jasonBrom/ch592f-keydeck/web/README.md

# KeyDeck 控制台

无框架的静态 HTML / CSS / ES Modules，设备协议、编辑器与模型资源均位于 `public/`，不依赖 CDN。Node 22+ 用于测试和静态打包；运行设备控制台本身不需要 Node。

```sh
python start-console.py            # 本地设备控制台，默认 localhost:8792
npm test                          # 浏览器逻辑与配置协议测试
npm run build                     # 输出 dist/，并检查资源与相对路径
```

Windows 可以双击 `StartConsole.cmd`；需要配对蓝牙管理时安装 `requirements-windows.txt`，启动器可安装到本目录 `.runtime/`。不要通过 `file://` 直接打开 HTML。

| 运行方式 | USB | 浏览器蓝牙 | Windows 已配对蓝牙 |
| --- | --- | --- | --- |
| GitHub Pages / HTTPS | WebHID | Web Bluetooth | 启动本地服务后点击「Windows 已配对」 |
| Python 本地控制台 | WebHID | Web Bluetooth | Bleak / WinRT，可用时自动识别 |
| 普通静态 localhost | WebHID | Web Bluetooth | 不可用 |

以上接口还取决于浏览器、系统与权限。首次选设备需点击授权；在线页与本地页的权限分别管理。在线页仅在点击「连接设备」或「Windows 已配对」后访问 `127.0.0.1:8792`；首次可能需要允许浏览器访问本机网络。电脑必须运行本地服务，GitHub Pages 无法直接运行 WinRT。没有云端设备数据存储。

## 主要代码

- `public/index.html`：页面结构和控件。
- `public/config/console.css`、`console-shell.css`：与原本地版一致的深色界面；`connection-ui.css` 补充连接指引，`workspace.css` 定义模型/编辑器比例与紧凑布局。
- `public/config/console.js`：草稿、改键、宏和统一测试/保存流程。
- `public/config/console-experience.js`：运行环境、无震动版提示与键盘导航。
- `public/config/layer-colors.js`：稳定的配置层色块控件与独立指示灯预览，沿用固件现有 RGB 字段。
- `public/config/schema.js`：1024 字节配置编解码、校验和协议帧。
- `public/config/transport.js`：USB/BLE 传输、分包、事务、回读。
- `public/config/connection.js`：已授权设备发现与连接优先级。
- `public/config/windows-bluetooth.js`：本地服务客户端；官方在线站点可显式连接回环服务。
- `public/config/*-editor.js`：触觉、配置层、状态灯等独立编辑器。
- `public/assembly.html`、`app.js`：可选三维装配视图。默认使用三维交互视图，保留输入编号选择。模型区域滚轮缩放，支持加减、复位和放大预览；按 Esc 返回编辑器。
- `start-console.py`、`windows_ble.py`：本地服务。保留 loopback 监听、Host / Origin 检查、按来源区分的令牌、会话租约与命令白名单。跨站只放行官方 HTTPS Origin 下的配置 API，拒绝任意来源和静态文件跨站读取。

## 使用顺序

1. 点击「连接设备」依次尝试已授权 USB、Windows 已配对蓝牙和已授权浏览器蓝牙；USB 可用时不探测跨站本地服务。首次 USB / 浏览器蓝牙授权或指定通道可从「手动选择」进入。每次连接成功后自动读取一次配置，以设备当前配置刷新页面，包括替换连接前的离线草稿；连接不会写入设备。
2. 点击左侧按键或编号，选择动作；切换编辑层不会切换设备运行层。
3. 点击「测试」临时应用，或「保存到设备」写入 Flash 并完整回读。
4. 无震动版自动禁用触觉页，其他配置仍能读写；导入的触觉预留字段保留。

页面不会自动烧录固件，也不会在打开时自动写入设备。切换固件版本请先导出配置。
