jasonBrom/ch592f-keydeck/web/public/drawings/pcb-critical-coordinates.csv

id | ref | kind | layer | x | y | x_lower_left | y_lower_left | width | height | rotation_deg | pad_number | pad_shape | pad_type | copper_layer | hole_shape | plating | corner_radius | app_x | app_y | app_z | bore_axis_app | width_axis | height_axis | opening_plane | source | classification_note
SW4-pad-1 | SW4 | pad | PCB | -27.36 | 12.54 | 5.44 | 38.34 | 2.9 | 2.5 | 0 | 1 | rect | smd | B.Cu |  |  |  |  |  |  |  |  |  |  | https://item.szlcsc.com/51853006.html | LCSC official EasyEDA library land; original maker drawing labels reference land width (2.55) and height (2.5), so 2.90mm is the EDA library choice, not the drawing nominal.
SW4-pad-2 | SW4 | pad | PCB | -13.91 | 15.08 | 18.89 | 40.88 | 2.9 | 2.5 | 0 | 2 | rect | smd | B.Cu |  |  |  |  |  |  |  |  |  |  | https://item.szlcsc.com/51853006.html | LCSC official EasyEDA library land; original maker drawing labels reference land width (2.55) and height (2.5), so 2.90mm is the EDA library choice, not the drawing nominal.
SW4-drill-3 | SW4 | drill | PCB | -23.81 | 12.54 | 8.99 | 38.34 | 3.0 | 3.0 | 0 | SOCKET1 |  |  |  | circle | NPTH |  |  |  |  |  |  |  |  | https://item.szlcsc.com/51853006.html | manufacturer_recommended; socket drawing positional/hole tolerance ±0.05mm
SW4-drill-4 | SW4 | drill | PCB | -17.46 | 15.08 | 15.34 | 40.88 | 3.0 | 3.0 | 0 | SOCKET2 |  |  |  | circle | NPTH |  |  |  |  |  |  |  |  | https://item.szlcsc.com/51853006.html | manufacturer_recommended; socket drawing positional/hole tolerance ±0.05mm
SW4-drill-5 | SW4 | drill | PCB | -20.0 | 10.0 | 12.8 | 35.8 | 4.0 | 4.0 | 0 | CENTER |  |  |  | circle | NPTH |  |  |  |  |  |  |  |  | https://item.szlcsc.com/51853006.html | existing_design_assumption; SAMZO drawing specifies column diameters 3.85 and 1.65, not PCB drill sizes. Retained prototype drill must be verified on first article.
SW4-drill-6 | SW4 | drill | PCB | -25.08 | 10.0 | 7.72 | 35.8 | 2.0 | 2.0 | 0 | LOC_L |  |  |  | circle | NPTH |  |  |  |  |  |  |  |  | https://item.szlcsc.com/51853006.html | existing_design_assumption; SAMZO drawing specifies column diameters 3.85 and 1.65, not PCB drill sizes. Retained prototype drill must be verified on first article.
SW4-drill-7 | SW4 | drill | PCB | -14.92 | 10.0 | 17.88 | 35.8 | 2.0 | 2.0 | 0 | LOC_R |  |  |  | circle | NPTH |  |  |  |  |  |  |  |  | https://item.szlcsc.com/51853006.html | existing_design_assumption; SAMZO drawing specifies column diameters 3.85 and 1.65, not PCB drill sizes. Retained prototype drill must be verified on first article.
RGB1-window | D2 | window | PCB | -20 | 4.8 | 12.8 | 30.6 | 3.4 | 3 | 0 |  |  |  |  |  | none | 0.15 |  |  |  |  |  |  |  | Rev.D RGB footprint window + assembly proposal corner relief
D2-pad-1 | D2 | pad | PCB | -22.7 | 5.57 | 10.1 | 31.37 | 1.7 | 0.8 | 0.0 | 1 | rect | smd | B.Cu |  |  |  |  |  |  |  |  |  |  | Rev.D/LED_GL6028RGB01H-W_ReverseMount.kicad_mod
D2-pad-2 | D2 | pad | PCB | -22.7 | 4.03 | 10.1 | 29.83 | 1.7 | 0.8 | 0.0 | 2 | rect | smd | B.Cu |  |  |  |  |  |  |  |  |  |  | Rev.D/LED_GL6028RGB01H-W_ReverseMount.kicad_mod
D2-pad-3 | D2 | pad | PCB | -17.3 | 4.03 | 15.5 | 29.83 | 1.7 | 0.8 | 0.0 | 3 | rect | smd | B.Cu |  |  |  |  |  |  |  |  |  |  | Rev.D/LED_GL6028RGB01H-W_ReverseMount.kicad_mod
D2-pad-4 | D2 | pad | PCB | -17.3 | 5.57 | 15.5 | 31.37 | 1.7 | 0.8 | 0.0 | 4 | rect | smd | B.Cu |  |  |  |  |  |  |  |  |  |  | Rev.D/LED_GL6028RGB01H-W_ReverseMount.kicad_mod
SW5-pad-1 | SW5 | pad | PCB | -7.36 | 12.54 | 25.44 | 38.34 | 2.9 | 2.5 | 0 | 1 | rect | smd | B.Cu |  |  |  |  |  |  |  |  |  |  | https://item.szlcsc.com/51853006.html | LCSC official EasyEDA library land; original maker drawing labels reference land width (2.55) and height (2.5), so 2.90mm is the EDA library choice, not the drawing nominal.
SW5-pad-2 | SW5 | pad | PCB | 6.09 | 15.08 | 38.89 | 40.88 | 2.9 | 2.5 | 0 | 2 | rect | smd | B.Cu |  |  |  |  |  |  |  |  |  |  | https://item.szlcsc.com/51853006.html | LCSC official EasyEDA library land; original maker drawing labels reference land width (2.55) and height (2.5), so 2.90mm is the EDA library choice, not the drawing nominal.
SW5-drill-3 | SW5 | drill | PCB | -3.81 | 12.54 | 28.99 | 38.34 | 3.0 | 3.0 | 0 | SOCKET1 |  |  |  | circle | NPTH |  |  |  |  |  |  |  |  | https://item.szlcsc.com/51853006.html | manufacturer_recommended; socket drawing positional/hole tolerance ±0.05mm
SW5-drill-4 | SW5 | drill | PCB | 2.54 | 15.08 | 35.34 | 40.88 | 3.0 | 3.0 | 0 | SOCKET2 |  |  |  | circle | NPTH |  |  |  |  |  |  |  |  | https://item.szlcsc.com/51853006.html | manufacturer_recommended; socket drawing positional/hole tolerance ±0.05mm
SW5-drill-5 | SW5 | drill | PCB | 0.0 | 10.0 | 32.8 | 35.8 | 4.0 | 4.0 | 0 | CENTER |  |  |  | circle | NPTH |  |  |  |  |  |  |  |  | https://item.szlcsc.com/51853006.html | existing_design_assumption; SAMZO drawing specifies column diameters 3.85 and 1.65, not PCB drill sizes. Retained prototype drill must be verified on first article.
SW5-drill-6 | SW5 | drill | PCB | -5.08 | 10.0 | 27.72 | 35.8 | 2.0 | 2.0 | 0 | LOC_L |  |  |  | circle | NPTH |  |  |  |  |  |  |  |  | https://item.szlcsc.com/51853006.html | existing_design_assumption; SAMZO drawing specifies column diameters 3.85 and 1.65, not PCB drill sizes. Retained prototype drill must be verified on first article.
SW5-drill-7 | SW5 | drill | PCB | 5.08 | 10.0 | 37.88 | 35.8 | 2.0 | 2.0 | 0 | LOC_R |  |  |  | circle | NPTH |  |  |  |  |  |  |  |  | https://item.szlcsc.com/51853006.html | existing_design_assumption; SAMZO drawing specifies column diameters 3.85 and 1.65, not PCB drill sizes. Retained prototype drill must be verified on first article.
RGB2-window | D3 | window | PCB | 0 | 4.8 | 32.8 | 30.6 | 3.4 | 3 | 0 |  |  |  |  |  | none | 0.15 |  |  |  |  |  |  |  | Rev.D RGB footprint window + assembly proposal corner relief
D3-pad-1 | D3 | pad | PCB | -2.7 | 5.57 | 30.1 | 31.37 | 1.7 | 0.8 | 0.0 | 1 | rect | smd | B.Cu |  |  |  |  |  |  |  |  |  |  | Rev.D/LED_GL6028RGB01H-W_ReverseMount.kicad_mod
D3-pad-2 | D3 | pad | PCB | -2.7 | 4.03 | 30.1 | 29.83 | 1.7 | 0.8 | 0.0 | 2 | rect | smd | B.Cu |  |  |  |  |  |  |  |  |  |  | Rev.D/LED_GL6028RGB01H-W_ReverseMount.kicad_mod
D3-pad-3 | D3 | pad | PCB | 2.7 | 4.03 | 35.5 | 29.83 | 1.7 | 0.8 | 0.0 | 3 | rect | smd | B.Cu |  |  |  |  |  |  |  |  |  |  | Rev.D/LED_GL6028RGB01H-W_ReverseMount.kicad_mod
D3-pad-4 | D3 | pad | PCB | 2.7 | 5.57 | 35.5 | 31.37 | 1.7 | 0.8 | 0.0 | 4 | rect | smd | B.Cu |  |  |  |  |  |  |  |  |  |  | Rev.D/LED_GL6028RGB01H-W_ReverseMount.kicad_mod
SW6-pad-1 | SW6 | pad | PCB | -27.36 | -7.46 | 5.44 | 18.34 | 2.9 | 2.5 | 0 | 1 | rect | smd | B.Cu |  |  |  |  |  |  |  |  |  |  | https://item.szlcsc.com/51853006.html | LCSC official EasyEDA library land; original maker drawing labels reference land width (2.55) and height (2.5), so 2.90mm is the EDA library choice, not the drawing nominal.
SW6-pad-2 | SW6 | pad | PCB | -13.91 | -4.92 | 18.89 | 20.88 | 2.9 | 2.5 | 0 | 2 | rect | smd | B.Cu |  |  |  |  |  |  |  |  |  |  | https://item.szlcsc.com/51853006.html | LCSC official EasyEDA library land; original maker drawing labels reference land width (2.55) and height (2.5), so 2.90mm is the EDA library choice, not the drawing nominal.
SW6-drill-3 | SW6 | drill | PCB | -23.81 | -7.46 | 8.99 | 18.34 | 3.0 | 3.0 | 0 | SOCKET1 |  |  |  | circle | NPTH |  |  |  |  |  |  |  |  | https://item.szlcsc.com/51853006.html | manufacturer_recommended; socket drawing positional/hole tolerance ±0.05mm
SW6-drill-4 | SW6 | drill | PCB | -17.46 | -4.92 | 15.34 | 20.88 | 3.0 | 3.0 | 0 | SOCKET2 |  |  |  | circle | NPTH |  |  |  |  |  |  |  |  | https://item.szlcsc.com/51853006.html | manufacturer_recommended; socket drawing positional/hole tolerance ±0.05mm
SW6-drill-5 | SW6 | drill | PCB | -20.0 | -10.0 | 12.8 | 15.8 | 4.0 | 4.0 | 0 | CENTER |  |  |  | circle | NPTH |  |  |  |  |  |  |  |  | https://item.szlcsc.com/51853006.html | existing_design_assumption; SAMZO drawing specifies column diameters 3.85 and 1.65, not PCB drill sizes. Retained prototype drill must be verified on first article.
SW6-drill-6 | SW6 | drill | PCB | -25.08 | -10.0 | 7.72 | 15.8 | 2.0 | 2.0 | 0 | LOC_L |  |  |  | circle | NPTH |  |  |  |  |  |  |  |  | https://item.szlcsc.com/51853006.html | existing_design_assumption; SAMZO drawing specifies column diameters 3.85 and 1.65, not PCB drill sizes. Retained prototype drill must be verified on first article.
SW6-drill-7 | SW6 | drill | PCB | -14.92 | -10.0 | 17.88 | 15.8 | 2.0 | 2.0 | 0 | LOC_R |  |  |  | circle | NPTH |  |  |  |  |  |  |  |  | https://item.szlcsc.com/51853006.html | existing_design_assumption; SAMZO drawing specifies column diameters 3.85 and 1.65, not PCB drill sizes. Retained prototype drill must be verified on first article.
RGB3-window | D4 | window | PCB | -20 | -15.2 | 12.8 | 10.6 | 3.4 | 3 | 0 |  |  |  |  |  | none | 0.15 |  |  |  |  |  |  |  | Rev.D RGB footprint window + assembly proposal corner relief
D4-pad-1 | D4 | pad | PCB | -22.7 | -14.43 | 10.1 | 11.37 | 1.7 | 0.8 | 0.0 | 1 | rect | smd | B.Cu |  |  |  |  |  |  |  |  |  |  | Rev.D/LED_GL6028RGB01H-W_ReverseMount.kicad_mod
D4-pad-2 | D4 | pad | PCB | -22.7 | -15.97 | 10.1 | 9.83 | 1.7 | 0.8 | 0.0 | 2 | rect | smd | B.Cu |  |  |  |  |  |  |  |  |  |  | Rev.D/LED_GL6028RGB01H-W_ReverseMount.kicad_mod
D4-pad-3 | D4 | pad | PCB | -17.3 | -15.97 | 15.5 | 9.83 | 1.7 | 0.8 | 0.0 | 3 | rect | smd | B.Cu |  |  |  |  |  |  |  |  |  |  | Rev.D/LED_GL6028RGB01H-W_ReverseMount.kicad_mod
D4-pad-4 | D4 | pad | PCB | -17.3 | -14.43 | 15.5 | 11.37 | 1.7 | 0.8 | 0.0 | 4 | rect | smd | B.Cu |  |  |  |  |  |  |  |  |  |  | Rev.D/LED_GL6028RGB01H-W_ReverseMount.kicad_mod
SW7-pad-1 | SW7 | pad | PCB | -7.36 | -7.46 | 25.44 | 18.34 | 2.9 | 2.5 | 0 | 1 | rect | smd | B.Cu |  |  |  |  |  |  |  |  |  |  | https://item.szlcsc.com/51853006.html | LCSC official EasyEDA library land; original maker drawing labels reference land width (2.55) and height (2.5), so 2.90mm is the EDA library choice, not the drawing nominal.
SW7-pad-2 | SW7 | pad | PCB | 6.09 | -4.92 | 38.89 | 20.88 | 2.9 | 2.5 | 0 | 2 | rect | smd | B.Cu |  |  |  |  |  |  |  |  |  |  | https://item.szlcsc.com/51853006.html | LCSC official EasyEDA library land; original maker drawing labels reference land width (2.55) and height (2.5), so 2.90mm is the EDA library choice, not the drawing nominal.
SW7-drill-3 | SW7 | drill | PCB | -3.81 | -7.46 | 28.99 | 18.34 | 3.0 | 3.0 | 0 | SOCKET1 |  |  |  | circle | NPTH |  |  |  |  |  |  |  |  | https://item.szlcsc.com/51853006.html | manufacturer_recommended; socket drawing positional/hole tolerance ±0.05mm
SW7-drill-4 | SW7 | drill | PCB | 2.54 | -4.92 | 35.34 | 20.88 | 3.0 | 3.0 | 0 | SOCKET2 |  |  |  | circle | NPTH |  |  |  |  |  |  |  |  | https://item.szlcsc.com/51853006.html | manufacturer_recommended; socket drawing positional/hole tolerance ±0.05mm
SW7-drill-5 | SW7 | drill | PCB | 0.0 | -10.0 | 32.8 | 15.8 | 4.0 | 4.0 | 0 | CENTER |  |  |  | circle | NPTH |  |  |  |  |  |  |  |  | https://item.szlcsc.com/51853006.html | existing_design_assumption; SAMZO drawing specifies column diameters 3.85 and 1.65, not PCB drill sizes. Retained prototype drill must be verified on first article.
SW7-drill-6 | SW7 | drill | PCB | -5.08 | -10.0 | 27.72 | 15.8 | 2.0 | 2.0 | 0 | LOC_L |  |  |  | circle | NPTH |  |  |  |  |  |  |  |  | https://item.szlcsc.com/51853006.html | existing_design_assumption; SAMZO drawing specifies column diameters 3.85 and 1.65, not PCB drill sizes. Retained prototype drill must be verified on first article.
SW7-drill-7 | SW7 | drill | PCB | 5.08 | -10.0 | 37.88 | 15.8 | 2.0 | 2.0 | 0 | LOC_R |  |  |  | circle | NPTH |  |  |  |  |  |  |  |  | https://item.szlcsc.com/51853006.html | existing_design_assumption; SAMZO drawing specifies column diameters 3.85 and 1.65, not PCB drill sizes. Retained prototype drill must be verified on first article.
RGB4-window | D5 | window | PCB | 0 | -15.2 | 32.8 | 10.6 | 3.4 | 3 | 0 |  |  |  |  |  | none | 0.15 |  |  |  |  |  |  |  | Rev.D RGB footprint window + assembly proposal corner relief
D5-pad-1 | D5 | pad | PCB | -2.7 | -14.43 | 30.1 | 11.37 | 1.7 | 0.8 | 0.0 | 1 | rect | smd | B.Cu |  |  |  |  |  |  |  |  |  |  | Rev.D/LED_GL6028RGB01H-W_ReverseMount.kicad_mod
D5-pad-2 | D5 | pad | PCB | -2.7 | -15.97 | 30.1 | 9.83 | 1.7 | 0.8 | 0.0 | 2 | rect | smd | B.Cu |  |  |  |  |  |  |  |  |  |  | Rev.D/LED_GL6028RGB01H-W_ReverseMount.kicad_mod
D5-pad-3 | D5 | pad | PCB | 2.7 | -15.97 | 35.5 | 9.83 | 1.7 | 0.8 | 0.0 | 3 | rect | smd | B.Cu |  |  |  |  |  |  |  |  |  |  | Rev.D/LED_GL6028RGB01H-W_ReverseMount.kicad_mod
D5-pad-4 | D5 | pad | PCB | 2.7 | -14.43 | 35.5 | 11.37 | 1.7 | 0.8 | 0.0 | 4 | rect | smd | B.Cu |  |  |  |  |  |  |  |  |  |  | Rev.D/LED_GL6028RGB01H-W_ReverseMount.kicad_mod
SW8-pad-1 | SW8 | pad | PCB | 12.64 | -7.46 | 45.44 | 18.34 | 2.9 | 2.5 | 0 | 1 | rect | smd | B.Cu |  |  |  |  |  |  |  |  |  |  | https://item.szlcsc.com/51853006.html | LCSC official EasyEDA library land; original maker drawing labels reference land width (2.55) and height (2.5), so 2.90mm is the EDA library choice, not the drawing nominal.
SW8-pad-2 | SW8 | pad | PCB | 26.09 | -4.92 | 58.89 | 20.88 | 2.9 | 2.5 | 0 | 2 | rect | smd | B.Cu |  |  |  |  |  |  |  |  |  |  | https://item.szlcsc.com/51853006.html | LCSC official EasyEDA library land; original maker drawing labels reference land width (2.55) and height (2.5), so 2.90mm is the EDA library choice, not the drawing nominal.
SW8-drill-3 | SW8 | drill | PCB | 16.19 | -7.46 | 48.99 | 18.34 | 3.0 | 3.0 | 0 | SOCKET1 |  |  |  | circle | NPTH |  |  |  |  |  |  |  |  | https://item.szlcsc.com/51853006.html | manufacturer_recommended; socket drawing positional/hole tolerance ±0.05mm
SW8-drill-4 | SW8 | drill | PCB | 22.54 | -4.92 | 55.34 | 20.88 | 3.0 | 3.0 | 0 | SOCKET2 |  |  |  | circle | NPTH |  |  |  |  |  |  |  |  | https://item.szlcsc.com/51853006.html | manufacturer_recommended; socket drawing positional/hole tolerance ±0.05mm
SW8-drill-5 | SW8 | drill | PCB | 20.0 | -10.0 | 52.8 | 15.8 | 4.0 | 4.0 | 0 | CENTER |  |  |  | circle | NPTH |  |  |  |  |  |  |  |  | https://item.szlcsc.com/51853006.html | existing_design_assumption; SAMZO drawing specifies column diameters 3.85 and 1.65, not PCB drill sizes. Retained prototype drill must be verified on first article.
SW8-drill-6 | SW8 | drill | PCB | 14.92 | -10.0 | 47.72 | 15.8 | 2.0 | 2.0 | 0 | LOC_L |  |  |  | circle | NPTH |  |  |  |  |  |  |  |  | https://item.szlcsc.com/51853006.html | existing_design_assumption; SAMZO drawing specifies column diameters 3.85 and 1.65, not PCB drill sizes. Retained prototype drill must be verified on first article.
SW8-drill-7 | SW8 | drill | PCB | 25.08 | -10.0 | 57.88 | 15.8 | 2.0 | 2.0 | 0 | LOC_R |  |  |  | circle | NPTH |  |  |  |  |  |  |  |  | https://item.szlcsc.com/51853006.html | existing_design_assumption; SAMZO drawing specifies column diameters 3.85 and 1.65, not PCB drill sizes. Retained prototype drill must be verified on first article.
RGB5-window | D6 | window | PCB | 20 | -15.2 | 52.8 | 10.6 | 3.4 | 3 | 0 |  |  |  |  |  | none | 0.15 |  |  |  |  |  |  |  | Rev.D RGB footprint window + assembly proposal corner relief
D6-pad-1 | D6 | pad | PCB | 17.3 | -14.43 | 50.1 | 11.37 | 1.7 | 0.8 | 0.0 | 1 | rect | smd | B.Cu |  |  |  |  |  |  |  |  |  |  | Rev.D/LED_GL6028RGB01H-W_ReverseMount.kicad_mod
D6-pad-2 | D6 | pad | PCB | 17.3 | -15.97 | 50.1 | 9.83 | 1.7 | 0.8 | 0.0 | 2 | rect | smd | B.Cu |  |  |  |  |  |  |  |  |  |  | Rev.D/LED_GL6028RGB01H-W_ReverseMount.kicad_mod
D6-pad-3 | D6 | pad | PCB | 22.7 | -15.97 | 55.5 | 9.83 | 1.7 | 0.8 | 0.0 | 3 | rect | smd | B.Cu |  |  |  |  |  |  |  |  |  |  | Rev.D/LED_GL6028RGB01H-W_ReverseMount.kicad_mod
D6-pad-4 | D6 | pad | PCB | 22.7 | -14.43 | 55.5 | 11.37 | 1.7 | 0.8 | 0.0 | 4 | rect | smd | B.Cu |  |  |  |  |  |  |  |  |  |  | Rev.D/LED_GL6028RGB01H-W_ReverseMount.kicad_mod
ENC1-drill-1 | ENC1 | drill | PCB | 17.5 | 2.5 | 50.3 | 28.3 | 1.0 | 1.0 | 0 | A |  |  |  | circle | PTH |  |  |  |  |  |  |  |  | https://www.bourns.com/docs/product-datasheets/pec11l.pdf | OEM hole position and Ø1.0 +0.2/-0 drill. Size field denotes hole only; copper annulus intentionally unspecified. Signal PTH is design intent.
ENC1-drill-2 | ENC1 | drill | PCB | 20.0 | 2.5 | 52.8 | 28.3 | 1.0 | 1.0 | 0 | C |  |  |  | circle | PTH |  |  |  |  |  |  |  |  | https://www.bourns.com/docs/product-datasheets/pec11l.pdf | OEM hole position and Ø1.0 +0.2/-0 drill. Size field denotes hole only; copper annulus intentionally unspecified. Signal PTH is design intent.
ENC1-drill-3 | ENC1 | drill | PCB | 22.5 | 2.5 | 55.3 | 28.3 | 1.0 | 1.0 | 0 | B |  |  |  | circle | PTH |  |  |  |  |  |  |  |  | https://www.bourns.com/docs/product-datasheets/pec11l.pdf | OEM hole position and Ø1.0 +0.2/-0 drill. Size field denotes hole only; copper annulus intentionally unspecified. Signal PTH is design intent.
ENC1-drill-4 | ENC1 | drill | PCB | 17.5 | 17.0 | 50.3 | 42.8 | 1.0 | 1.0 | 0 | SW1 |  |  |  | circle | PTH |  |  |  |  |  |  |  |  | https://www.bourns.com/docs/product-datasheets/pec11l.pdf | OEM hole position and Ø1.0 +0.2/-0 drill. Size field denotes hole only; copper annulus intentionally unspecified. Signal PTH is design intent.
ENC1-drill-5 | ENC1 | drill | PCB | 22.5 | 17.0 | 55.3 | 42.8 | 1.0 | 1.0 | 0 | SW2 |  |  |  | circle | PTH |  |  |  |  |  |  |  |  | https://www.bourns.com/docs/product-datasheets/pec11l.pdf | OEM hole position and Ø1.0 +0.2/-0 drill. Size field denotes hole only; copper annulus intentionally unspecified. Signal PTH is design intent.
ENC1-drill-6 | ENC1 | drill | PCB | 14.3 | 10.0 | 47.1 | 35.8 | 1.4 | 2.1 | 0 | SHIELD_LEFT |  |  |  | rect | UNSPECIFIED |  |  |  |  |  |  |  |  | https://www.bourns.com/docs/product-datasheets/pec11l.pdf | OEM 1.40 x 2.10 rectangular mounting envelope; corner radius, plating and copper unspecified. Must be selected by PCB engineer. Slot-center pitch derived as 12.80 outside span - 1.40 width = 11.40.
ENC1-drill-7 | ENC1 | drill | PCB | 25.7 | 10.0 | 58.5 | 35.8 | 1.4 | 2.1 | 0 | SHIELD_RIGHT |  |  |  | rect | UNSPECIFIED |  |  |  |  |  |  |  |  | https://www.bourns.com/docs/product-datasheets/pec11l.pdf | OEM 1.40 x 2.10 rectangular mounting envelope; corner radius, plating and copper unspecified. Must be selected by PCB engineer. Slot-center pitch derived as 12.80 outside span - 1.40 width = 11.40.
J1-pad-1 | J1 | pad | PCB | -3.2 | 19.82 | 29.6 | 45.62 | 0.6 | 1.14 | 180.0 | B1A12 | rect | smd | F.Cu |  |  |  |  |  |  |  |  |  |  | Rev.D/USB-C-SMD_GT-USB-7010ANS.kicad_mod
J1-pad-2 | J1 | pad | PCB | -2.4 | 19.82 | 30.4 | 45.62 | 0.6 | 1.14 | 180.0 | B4A9 | rect | smd | F.Cu |  |  |  |  |  |  |  |  |  |  | Rev.D/USB-C-SMD_GT-USB-7010ANS.kicad_mod
J1-pad-3 | J1 | pad | PCB | -1.75 | 19.82 | 31.05 | 45.62 | 0.3 | 1.14 | 180.0 | B5 | rect | smd | F.Cu |  |  |  |  |  |  |  |  |  |  | Rev.D/USB-C-SMD_GT-USB-7010ANS.kicad_mod
J1-pad-4 | J1 | pad | PCB | -1.25 | 19.82 | 31.55 | 45.62 | 0.3 | 1.14 | 180.0 | A8 | rect | smd | F.Cu |  |  |  |  |  |  |  |  |  |  | Rev.D/USB-C-SMD_GT-USB-7010ANS.kicad_mod
J1-pad-5 | J1 | pad | PCB | -0.75 | 19.82 | 32.05 | 45.62 | 0.3 | 1.14 | 180.0 | B6 | rect | smd | F.Cu |  |  |  |  |  |  |  |  |  |  | Rev.D/USB-C-SMD_GT-USB-7010ANS.kicad_mod
J1-pad-6 | J1 | pad | PCB | -0.25 | 19.82 | 32.55 | 45.62 | 0.3 | 1.14 | 180.0 | A7 | rect | smd | F.Cu |  |  |  |  |  |  |  |  |  |  | Rev.D/USB-C-SMD_GT-USB-7010ANS.kicad_mod
J1-pad-7 | J1 | pad | PCB | 0.25 | 19.82 | 33.05 | 45.62 | 0.3 | 1.14 | 180.0 | A6 | rect | smd | F.Cu |  |  |  |  |  |  |  |  |  |  | Rev.D/USB-C-SMD_GT-USB-7010ANS.kicad_mod
J1-pad-8 | J1 | pad | PCB | 0.75 | 19.82 | 33.55 | 45.62 | 0.3 | 1.14 | 180.0 | B7 | rect | smd | F.Cu |  |  |  |  |  |  |  |  |  |  | Rev.D/USB-C-SMD_GT-USB-7010ANS.kicad_mod
J1-pad-9 | J1 | pad | PCB | 1.25 | 19.82 | 34.05 | 45.62 | 0.3 | 1.14 | 180.0 | A5 | rect | smd | F.Cu |  |  |  |  |  |  |  |  |  |  | Rev.D/USB-C-SMD_GT-USB-7010ANS.kicad_mod
J1-pad-10 | J1 | pad | PCB | 1.75 | 19.82 | 34.55 | 45.62 | 0.3 | 1.14 | 180.0 | B8 | rect | smd | F.Cu |  |  |  |  |  |  |  |  |  |  | Rev.D/USB-C-SMD_GT-USB-7010ANS.kicad_mod
J1-pad-11 | J1 | pad | PCB | 2.4 | 19.82 | 35.2 | 45.62 | 0.6 | 1.14 | 180.0 | A4B9 | rect | smd | F.Cu |  |  |  |  |  |  |  |  |  |  | Rev.D/USB-C-SMD_GT-USB-7010ANS.kicad_mod
J1-pad-12 | J1 | pad | PCB | 3.2 | 19.82 | 36.0 | 45.62 | 0.6 | 1.14 | 180.0 | A1B12 | rect | smd | F.Cu |  |  |  |  |  |  |  |  |  |  | Rev.D/USB-C-SMD_GT-USB-7010ANS.kicad_mod
J1-pad-13 | J1 | pad | PCB | 4.32 | 20.4 | 37.12 | 46.2 | 1.0 | 2.1 | 180.0 | 1 | oval | thru_hole | *.Cu |  |  |  |  |  |  |  |  |  |  | Rev.D/USB-C-SMD_GT-USB-7010ANS.kicad_mod
J1-drill-13 | J1 | drill | PCB | 4.32 | 20.4 | 37.12 | 46.2 | 0.599998 | 1.699997 | 180.0 | 1 |  |  |  | oval | PTH |  |  |  |  |  |  |  |  | Rev.D/USB-C-SMD_GT-USB-7010ANS.kicad_mod
J1-pad-14 | J1 | pad | PCB | 4.32 | 24.58 | 37.12 | 50.38 | 1.0 | 1.8 | 180.0 | 4 | oval | thru_hole | *.Cu |  |  |  |  |  |  |  |  |  |  | Rev.D/USB-C-SMD_GT-USB-7010ANS.kicad_mod
J1-drill-14 | J1 | drill | PCB | 4.32 | 24.58 | 37.12 | 50.38 | 0.599998 | 1.399997 | 180.0 | 4 |  |  |  | oval | PTH |  |  |  |  |  |  |  |  | Rev.D/USB-C-SMD_GT-USB-7010ANS.kicad_mod
J1-pad-15 | J1 | pad | PCB | -4.32 | 24.58 | 28.48 | 50.38 | 1.0 | 1.8 | 180.0 | 3 | oval | thru_hole | *.Cu |  |  |  |  |  |  |  |  |  |  | Rev.D/USB-C-SMD_GT-USB-7010ANS.kicad_mod
J1-drill-15 | J1 | drill | PCB | -4.32 | 24.58 | 28.48 | 50.38 | 0.599998 | 1.399997 | 180.0 | 3 |  |  |  | oval | PTH |  |  |  |  |  |  |  |  | Rev.D/USB-C-SMD_GT-USB-7010ANS.kicad_mod
J1-pad-16 | J1 | pad | PCB | -4.32 | 20.39 | 28.48 | 46.19 | 1.0 | 2.1 | 180.0 | 2 | oval | thru_hole | *.Cu |  |  |  |  |  |  |  |  |  |  | Rev.D/USB-C-SMD_GT-USB-7010ANS.kicad_mod
J1-drill-16 | J1 | drill | PCB | -4.32 | 20.39 | 28.48 | 46.19 | 0.599998 | 1.700022 | 180.0 | 2 |  |  |  | oval | PTH |  |  |  |  |  |  |  |  | Rev.D/USB-C-SMD_GT-USB-7010ANS.kicad_mod
J1-drill-17 | J1 | drill | PCB | -2.89 | 20.9 | 29.91 | 46.7 | 0.65 | 0.65 | 180 |  |  |  |  | circle | NPTH |  |  |  |  |  |  |  |  | Rev.D/USB-C-SMD_GT-USB-7010ANS.kicad_mod | Source uses blank-number thru_hole; treated as mechanical NPTH in this proposal.
J1-drill-18 | J1 | drill | PCB | 2.89 | 20.9 | 35.69 | 46.7 | 0.65 | 0.65 | 180 |  |  |  |  | circle | NPTH |  |  |  |  |  |  |  |  | Rev.D/USB-C-SMD_GT-USB-7010ANS.kicad_mod | Source uses blank-number thru_hole; treated as mechanical NPTH in this proposal.
SW2-pad-1 | SW2 | pad | PCB | -29.2 | 5.325 | 3.6 | 31.125 | 0.65 | 0.9 | 90 | 1 | rect | smd | F.Cu |  |  |  |  |  |  |  |  |  |  | https://datasheet.lcsc.com/datasheet/pdf/8c19e09b9abd1bb54aeb693a8cdb347b.pdf?productCode=C2762970 | Position dimensioned. Copper size proposed. Signal numbers 1/2 assigned for this project; vendor drawing labels both A.
SW2-pad-2 | SW2 | pad | PCB | -29.2 | 8.675 | 3.6 | 34.475 | 0.65 | 0.9 | 90 | 2 | rect | smd | F.Cu |  |  |  |  |  |  |  |  |  |  | https://datasheet.lcsc.com/datasheet/pdf/8c19e09b9abd1bb54aeb693a8cdb347b.pdf?productCode=C2762970 | Position dimensioned. Copper size proposed. Signal numbers 1/2 assigned for this project; vendor drawing labels both A.
SW2-pad-3 | SW2 | pad | PCB | -30.775 | 4.75 | 2.025 | 30.55 | 0.5 | 0.75 | 90 | MP1 | rect | smd | F.Cu |  |  |  |  |  |  |  |  |  |  | https://datasheet.lcsc.com/datasheet/pdf/8c19e09b9abd1bb54aeb693a8cdb347b.pdf?productCode=C2762970 | X position dimensioned. Center Y and copper size proposed. Anchor labels MP1/MP2 assigned for this project.
SW2-pad-4 | SW2 | pad | PCB | -30.775 | 9.25 | 2.025 | 35.05 | 0.5 | 0.75 | 90 | MP2 | rect | smd | F.Cu |  |  |  |  |  |  |  |  |  |  | https://datasheet.lcsc.com/datasheet/pdf/8c19e09b9abd1bb54aeb693a8cdb347b.pdf?productCode=C2762970 | X position dimensioned. Center Y and copper size proposed. Anchor labels MP1/MP2 assigned for this project.
SW2-drill-5 | SW2 | drill | PCB | -30.4 | 6.15 | 2.4 | 31.95 | 0.65 | 0.65 | 90 | NP1 |  |  |  | circle | NPTH |  |  |  |  |  |  |  |  | https://datasheet.lcsc.com/datasheet/pdf/8c19e09b9abd1bb54aeb693a8cdb347b.pdf?productCode=C2762970 | 0.65 proposed PCB clearance for the verified 0.50 locating peg; not a manufacturer hole specification
SW2-drill-6 | SW2 | drill | PCB | -30.4 | 7.85 | 2.4 | 33.65 | 0.65 | 0.65 | 90 | NP2 |  |  |  | circle | NPTH |  |  |  |  |  |  |  |  | https://datasheet.lcsc.com/datasheet/pdf/8c19e09b9abd1bb54aeb693a8cdb347b.pdf?productCode=C2762970 | 0.65 proposed PCB clearance for the verified 0.50 locating peg; not a manufacturer hole specification
SW3-pad-1 | SW3 | pad | PCB | -29.2 | -8.675 | 3.6 | 17.125 | 0.65 | 0.9 | 90 | 1 | rect | smd | F.Cu |  |  |  |  |  |  |  |  |  |  | https://datasheet.lcsc.com/datasheet/pdf/8c19e09b9abd1bb54aeb693a8cdb347b.pdf?productCode=C2762970 | Position dimensioned. Copper size proposed. Signal numbers 1/2 assigned for this project; vendor drawing labels both A.
SW3-pad-2 | SW3 | pad | PCB | -29.2 | -5.325 | 3.6 | 20.475 | 0.65 | 0.9 | 90 | 2 | rect | smd | F.Cu |  |  |  |  |  |  |  |  |  |  | https://datasheet.lcsc.com/datasheet/pdf/8c19e09b9abd1bb54aeb693a8cdb347b.pdf?productCode=C2762970 | Position dimensioned. Copper size proposed. Signal numbers 1/2 assigned for this project; vendor drawing labels both A.
SW3-pad-3 | SW3 | pad | PCB | -30.775 | -9.25 | 2.025 | 16.55 | 0.5 | 0.75 | 90 | MP1 | rect | smd | F.Cu |  |  |  |  |  |  |  |  |  |  | https://datasheet.lcsc.com/datasheet/pdf/8c19e09b9abd1bb54aeb693a8cdb347b.pdf?productCode=C2762970 | X position dimensioned. Center Y and copper size proposed. Anchor labels MP1/MP2 assigned for this project.
SW3-pad-4 | SW3 | pad | PCB | -30.775 | -4.75 | 2.025 | 21.05 | 0.5 | 0.75 | 90 | MP2 | rect | smd | F.Cu |  |  |  |  |  |  |  |  |  |  | https://datasheet.lcsc.com/datasheet/pdf/8c19e09b9abd1bb54aeb693a8cdb347b.pdf?productCode=C2762970 | X position dimensioned. Center Y and copper size proposed. Anchor labels MP1/MP2 assigned for this project.
SW3-drill-5 | SW3 | drill | PCB | -30.4 | -7.85 | 2.4 | 17.95 | 0.65 | 0.65 | 90 | NP1 |  |  |  | circle | NPTH |  |  |  |  |  |  |  |  | https://datasheet.lcsc.com/datasheet/pdf/8c19e09b9abd1bb54aeb693a8cdb347b.pdf?productCode=C2762970 | 0.65 proposed PCB clearance for the verified 0.50 locating peg; not a manufacturer hole specification
SW3-drill-6 | SW3 | drill | PCB | -30.4 | -6.15 | 2.4 | 19.65 | 0.65 | 0.65 | 90 | NP2 |  |  |  | circle | NPTH |  |  |  |  |  |  |  |  | https://datasheet.lcsc.com/datasheet/pdf/8c19e09b9abd1bb54aeb693a8cdb347b.pdf?productCode=C2762970 | 0.65 proposed PCB clearance for the verified 0.50 locating peg; not a manufacturer hole specification
SW2-wall-access | SW2 | case_opening | CASE_ONLY | -35 | 7 | -2.2 | 32.8 | 1.6 | 1.6 | 0 |  |  |  |  | circle | none |  | -35 | 14.55 | -7 | [1, 0, 0] | app Z | app Y | left wall; width and height are not in PCB plane | Enclosure Print06: left sidewall access only; no PCB drill
SW3-wall-access | SW3 | case_opening | CASE_ONLY | -35 | -7 | -2.2 | 18.8 | 1.6 | 1.6 | 0 |  |  |  |  | circle | none |  | -35 | 14.55 | 7 | [1, 0, 0] | app Z | app Y | left wall; width and height are not in PCB plane | Enclosure Print06: left sidewall access only; no PCB drill
J1-case-opening | J1 | case_opening | CASE_ONLY | 0 | 28 | 32.8 | 53.8 | 9.6 | 3.8 | 0 |  |  |  |  | roundrect | none | 1.2 | 0 | 15.28 | -28 | [0, 0, 1] | app X | app Y | rear wall; width and height are not in PCB plane | Enclosure Print06: USB rear sidewall throat only; no PCB drill
SW1-pad-1 | SW1 | pad | PCB | 25.250059 | 22.053674 | 58.050059 | 47.853674 | 0.8999982 | 1.999996 | 0.0 | 1 | rect | smd | F.Cu |  |  |  |  |  |  |  |  |  |  | LCSC / EasyEDA C963206 footprint; enlarged lands compared with vendor PDF
SW1-pad-2 | SW1 | pad | PCB | 22.250065 | 22.053674 | 55.050065 | 47.853674 | 0.8999982 | 1.999996 | 0.0 | 2 | rect | smd | F.Cu |  |  |  |  |  |  |  |  |  |  | LCSC / EasyEDA C963206 footprint; enlarged lands compared with vendor PDF
SW1-pad-3 | SW1 | pad | PCB | 20.750195 | 22.053674 | 53.550195 | 47.853674 | 0.8999982 | 1.999996 | 0.0 | 3 | rect | smd | F.Cu |  |  |  |  |  |  |  |  |  |  | LCSC / EasyEDA C963206 footprint; enlarged lands compared with vendor PDF
SW1-pad-4 | SW1 | pad | PCB | 19.200033 | 22.765128 | 52.000033 | 48.565128 | 1.0999978 | 0.9299956 | 0.0 | 4 | rect | smd | F.Cu |  |  |  |  |  |  |  |  |  |  | LCSC / EasyEDA C963206 footprint; enlarged lands compared with vendor PDF
SW1-pad-5 | SW1 | pad | PCB | 19.200033 | 25.035126 | 52.000033 | 50.835126 | 1.0999978 | 0.9299956 | 0.0 | 5 | rect | smd | F.Cu |  |  |  |  |  |  |  |  |  |  | LCSC / EasyEDA C963206 footprint; enlarged lands compared with vendor PDF
SW1-pad-6 | SW1 | pad | PCB | 26.799967 | 25.035126 | 59.599967 | 50.835126 | 1.0999978 | 0.9299956 | 0.0 | 6 | rect | smd | F.Cu |  |  |  |  |  |  |  |  |  |  | LCSC / EasyEDA C963206 footprint; enlarged lands compared with vendor PDF
SW1-pad-7 | SW1 | pad | PCB | 26.799967 | 22.765128 | 59.599967 | 48.565128 | 1.0999978 | 0.9299956 | 180.0 | 7 | rect | smd | F.Cu |  |  |  |  |  |  |  |  |  |  | LCSC / EasyEDA C963206 footprint; enlarged lands compared with vendor PDF
SW1-locator-gge42 | SW1 | drill | PCB | 21.500003 | 23.9 | 54.300003 | 49.7 | 0.8499856 | 0.8499856 | 0 |  |  |  |  | circle | NPTH |  |  |  |  |  |  |  |  | LCSC / EasyEDA C963206 locator hole
SW1-locator-gge51 | SW1 | drill | PCB | 24.499997 | 23.9 | 57.299997 | 49.7 | 0.8499856 | 0.8499856 | 0 |  |  |  |  | circle | NPTH |  |  |  |  |  |  |  |  | LCSC / EasyEDA C963206 locator hole
H1 | H1 | drill | PCB | -30 | 22 | 2.8 | 47.8 | 2.4 | 2.4 | 0 |  |  |  |  | circle | NPTH |  |  |  |  |  |  |  |  | Enclosure Print06 / M2 clearance mounting hole
H2 | H2 | drill | PCB | 30 | 22 | 62.8 | 47.8 | 2.4 | 2.4 | 0 |  |  |  |  | circle | NPTH |  |  |  |  |  |  |  |  | Enclosure Print06 / M2 clearance mounting hole
H3 | H3 | drill | PCB | -30 | -22 | 2.8 | 3.8 | 2.4 | 2.4 | 0 |  |  |  |  | circle | NPTH |  |  |  |  |  |  |  |  | Enclosure Print06 / M2 clearance mounting hole
H4 | H4 | drill | PCB | 30 | -22 | 62.8 | 3.8 | 2.4 | 2.4 | 0 |  |  |  |  | circle | NPTH |  |  |  |  |  |  |  |  | Enclosure Print06 / M2 clearance mounting hole
ENC1-lid-shaft-opening | ENC1 | case_opening | CASE_ONLY | 20 | 10 | 52.8 | 35.8 | 7.4 | 7.4 | 0 |  |  |  |  | circle | none |  | 20 | 20 | -10 | [0, -1, 0] | app X | app Z | lid top; not PCB plane | Enclosure Print06: M7 bushing clearance in lid; not PCB hole
SW4-plate-opening | SW4 | plate_opening | CASE_ONLY | -20 | 10 | 12.8 | 35.8 | 14.1 | 14.1 | 0 |  |  |  |  | roundrect | none | 0.15 | -20 | 18.6 | -10 | [0, 1, 0] | app X | app Z | lid horizontal switch retention plane; not PCB drill | Enclosure Print06 integral switch retention ledge
SW5-plate-opening | SW5 | plate_opening | CASE_ONLY | 0 | 10 | 32.8 | 35.8 | 14.1 | 14.1 | 0 |  |  |  |  | roundrect | none | 0.15 | 0 | 18.6 | -10 | [0, 1, 0] | app X | app Z | lid horizontal switch retention plane; not PCB drill | Enclosure Print06 integral switch retention ledge
SW6-plate-opening | SW6 | plate_opening | CASE_ONLY | -20 | -10 | 12.8 | 15.8 | 14.1 | 14.1 | 0 |  |  |  |  | roundrect | none | 0.15 | -20 | 18.6 | 10 | [0, 1, 0] | app X | app Z | lid horizontal switch retention plane; not PCB drill | Enclosure Print06 integral switch retention ledge
SW7-plate-opening | SW7 | plate_opening | CASE_ONLY | 0 | -10 | 32.8 | 15.8 | 14.1 | 14.1 | 0 |  |  |  |  | roundrect | none | 0.15 | 0 | 18.6 | 10 | [0, 1, 0] | app X | app Z | lid horizontal switch retention plane; not PCB drill | Enclosure Print06 integral switch retention ledge
SW8-plate-opening | SW8 | plate_opening | CASE_ONLY | 20 | -10 | 52.8 | 15.8 | 14.1 | 14.1 | 0 |  |  |  |  | roundrect | none | 0.15 | 20 | 18.6 | 10 | [0, 1, 0] | app X | app Z | lid horizontal switch retention plane; not PCB drill | Enclosure Print06 integral switch retention ledge
