jasonBrom/ch592f-keydeck/web/public/drawings/switch-retention-openings.dxf

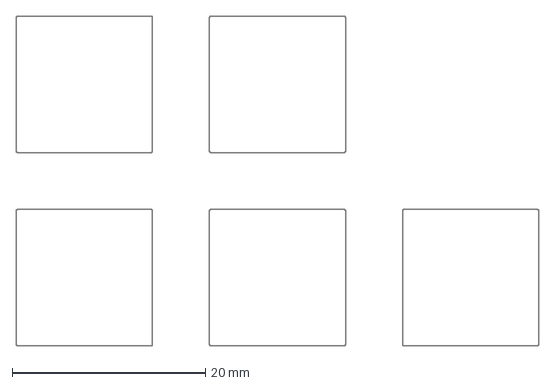
[picture p6: CAD file, 2026-10-21]
web/public/drawings/switch-retention-openings.dxf
54.1 x 34.1 mm
