jasonBrom/ch592f-keydeck/web/public/print/key-locator-14.0.stl

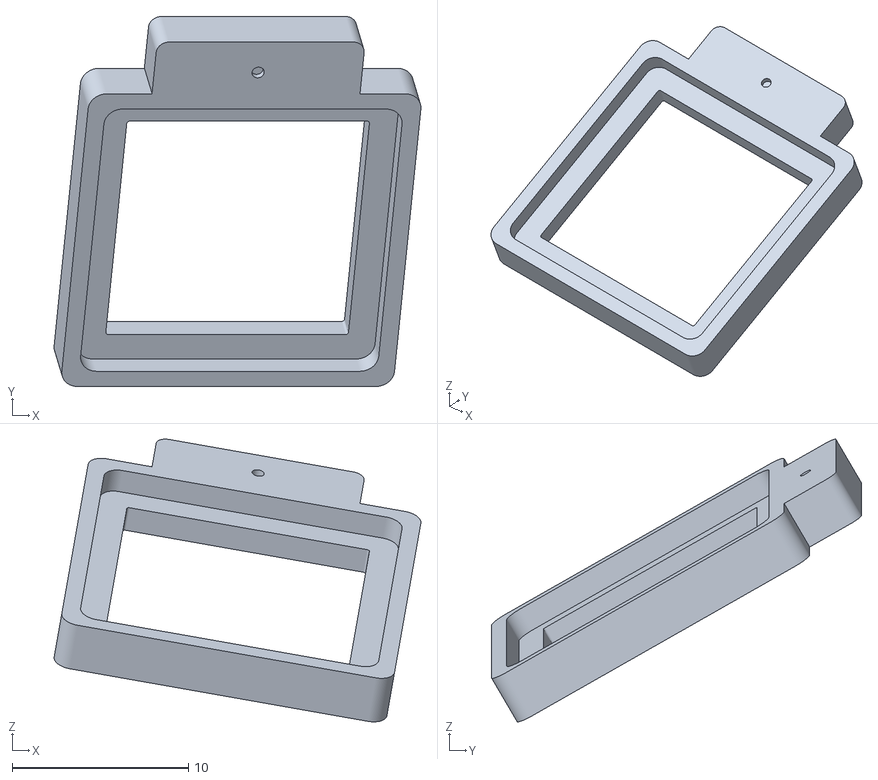
[picture p7: CAD file, 2026-10-21]
web/public/print/key-locator-14.0.stl
20.8 x 21.0 x 16.1
