jasonBrom/ch592f-keydeck/web/public/drawings/pcb-outline-holes.dxf

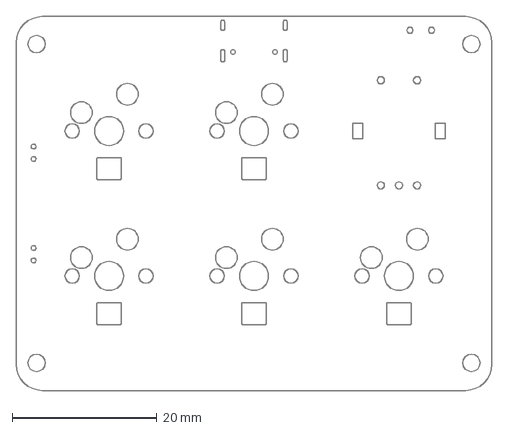
[picture p8: CAD file, 2026-10-21]
web/public/drawings/pcb-outline-holes.dxf
65.6 x 51.6 mm
