jasonBrom/ch592f-keydeck/web/public/print/upper-shell.stl

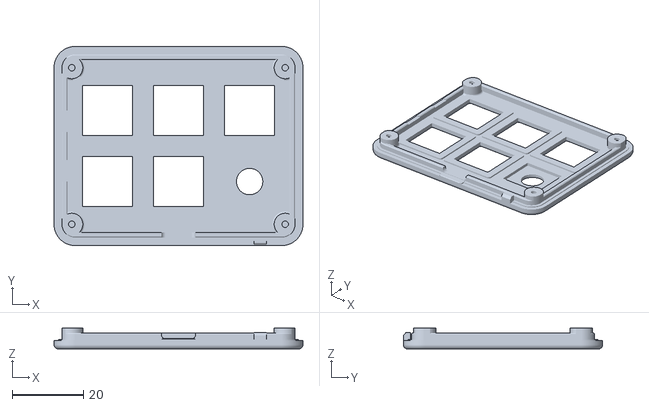
[picture p9: CAD file, 2026-10-21]
web/public/print/upper-shell.stl
70.0 x 56.0 x 5.90
