jasonBrom/ch592f-keydeck/web/public/print/lower-fit-corner.stl

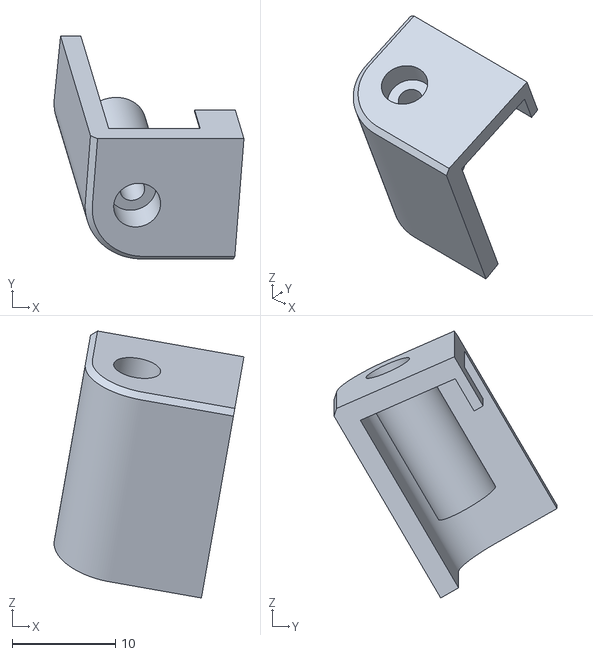
[picture p10: CAD file, 2026-10-21]
web/public/print/lower-fit-corner.stl
18.4 x 21.6 x 25.9
