jasonBrom/ch592f-keydeck/web/public/print/upper-resin.stl

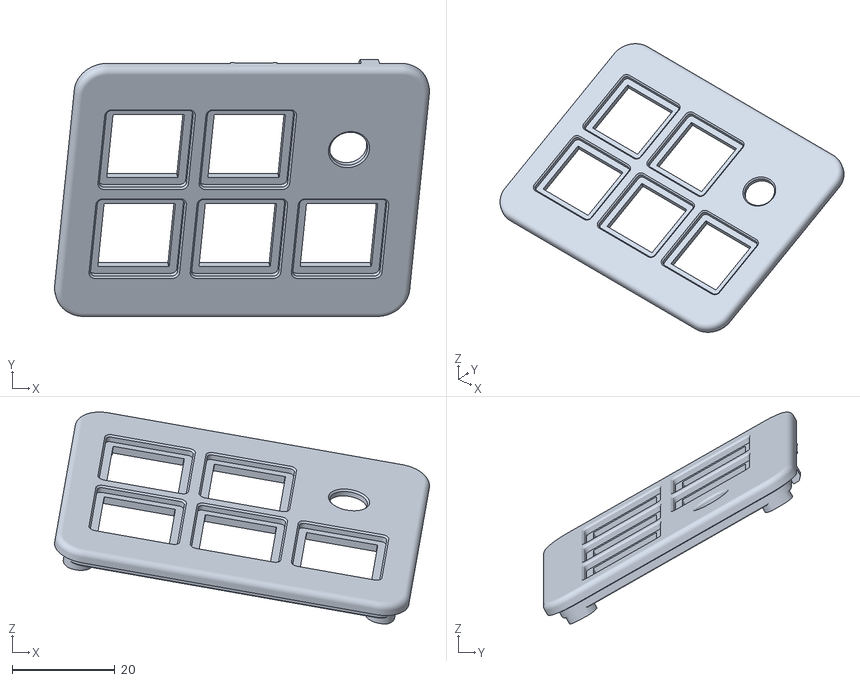
[picture p11: CAD file, 2026-10-21]
web/public/print/upper-resin.stl
73.0 x 50.0 x 41.2
