jasonBrom/ch592f-keydeck/web/public/print/selftap-fit.stl

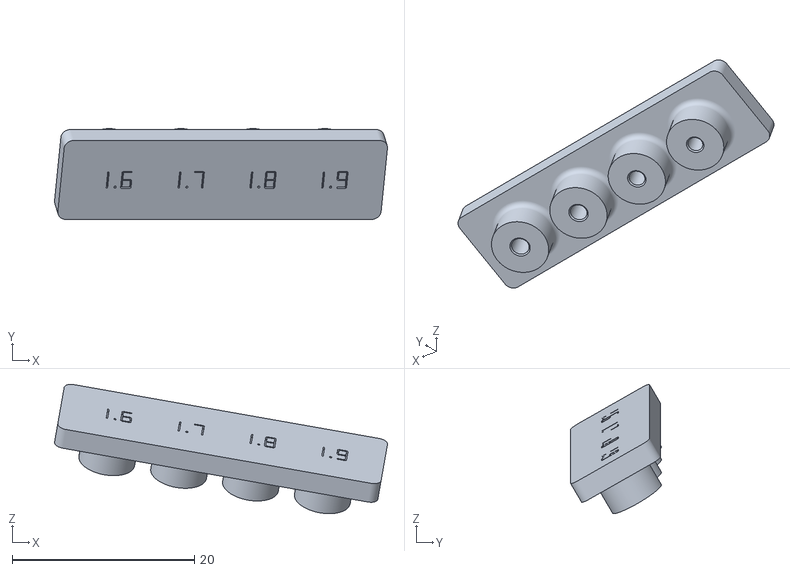
[picture p12: CAD file, 2026-10-21]
web/public/print/selftap-fit.stl
36.5 x 9.96 x 14.2
