jasonBrom/ch592f-keydeck/web/public/print/upper-side-access-fit.stl

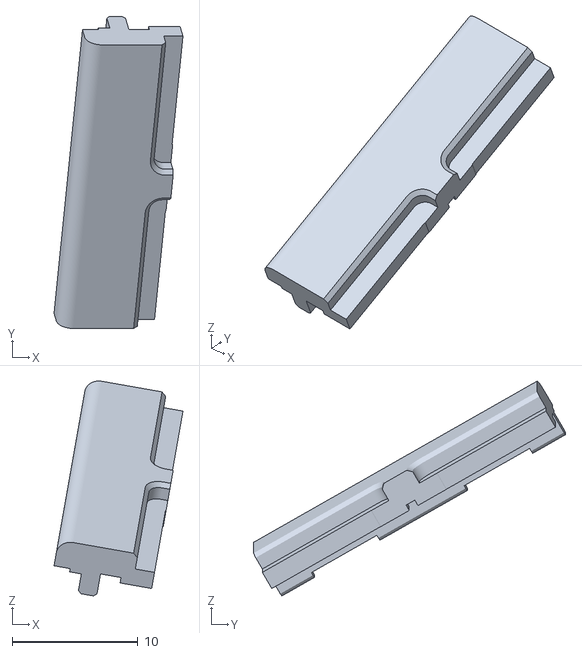
[picture p13: CAD file, 2026-10-21]
web/public/print/upper-side-access-fit.stl
10.2 x 24.8 x 17.1
