jasonBrom/ch592f-keydeck/web/public/print/lower-port-fit.stl

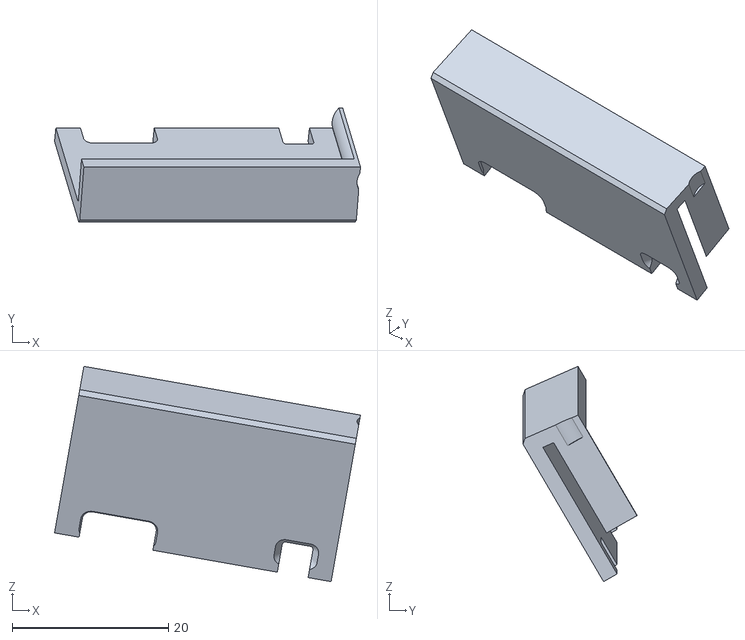
[picture p14: CAD file, 2026-10-21]
web/public/print/lower-port-fit.stl
39.2 x 14.6 x 27.6
