jasonBrom/ch592f-keydeck/web/public/print/lower-shell.stl

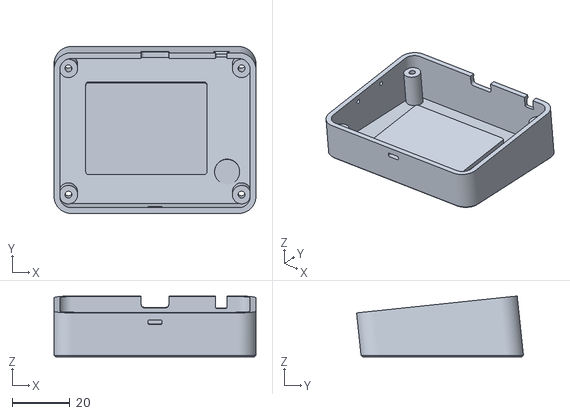
[picture p15: CAD file, 2026-10-21]
web/public/print/lower-shell.stl
70.0 x 57.9 x 21.1
