jasonBrom/ch592f-keydeck/web/public/print/lower-side-access-fit.stl

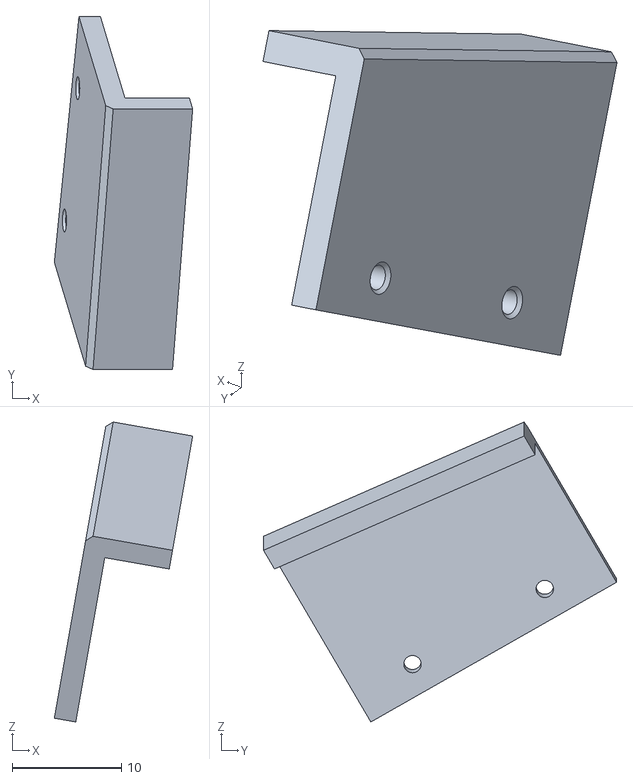
[picture p17: CAD file, 2026-10-21]
web/public/print/lower-side-access-fit.stl
12.7 x 32.4 x 27.5
