jasonBrom/ch592f-keydeck/web/public/print/upper-fit-corner.stl

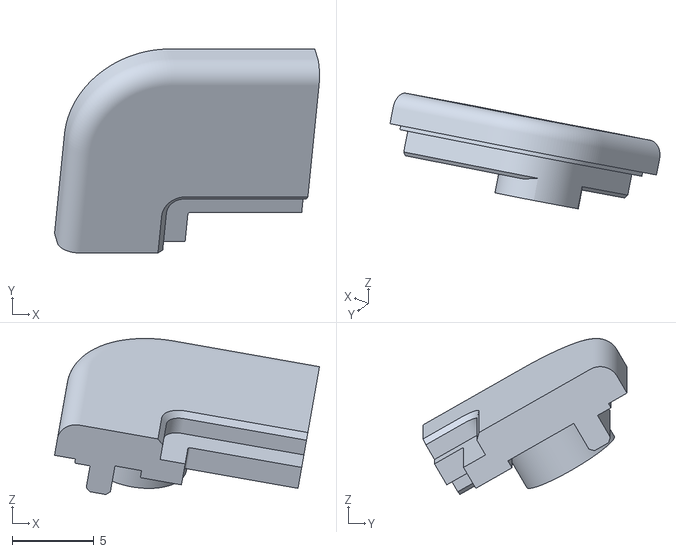
[picture p18: CAD file, 2026-10-21]
web/public/print/upper-fit-corner.stl
16.2 x 12.5 x 9.53
