jasonBrom/ch592f-keydeck/web/public/print/upper-port-fit.stl

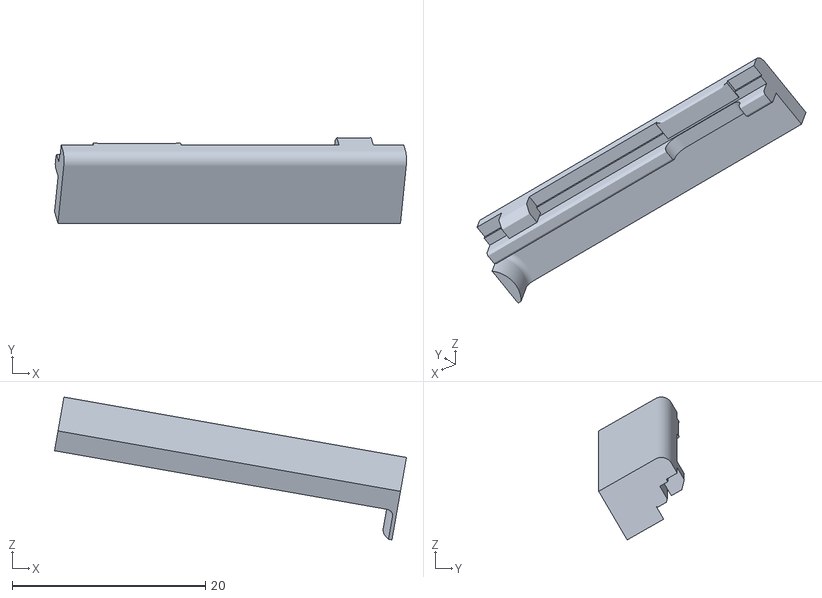
[picture p19: CAD file, 2026-10-21]
web/public/print/upper-port-fit.stl
36.4 x 8.87 x 14.8
