jasonBrom/ch592f-keydeck/web/public/print/lower-resin.stl

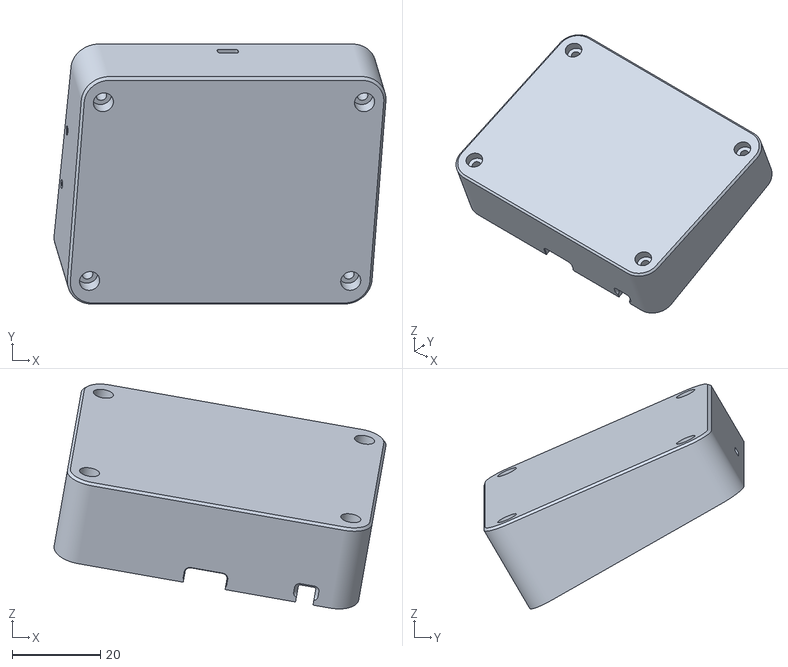
[picture p20: CAD file, 2026-10-21]
web/public/print/lower-resin.stl
75.1 x 58.8 x 50.9
