jasonBrom/ch592f-keydeck/(list of files, cad)

Other CAD files:
web/public/print/key-locator-14.1.stl
