jasonBrom/ch592f-keydeck/web/public/drawings/CH592-PCB-Print04.pdf

# CH592 / PCB mechanical layout

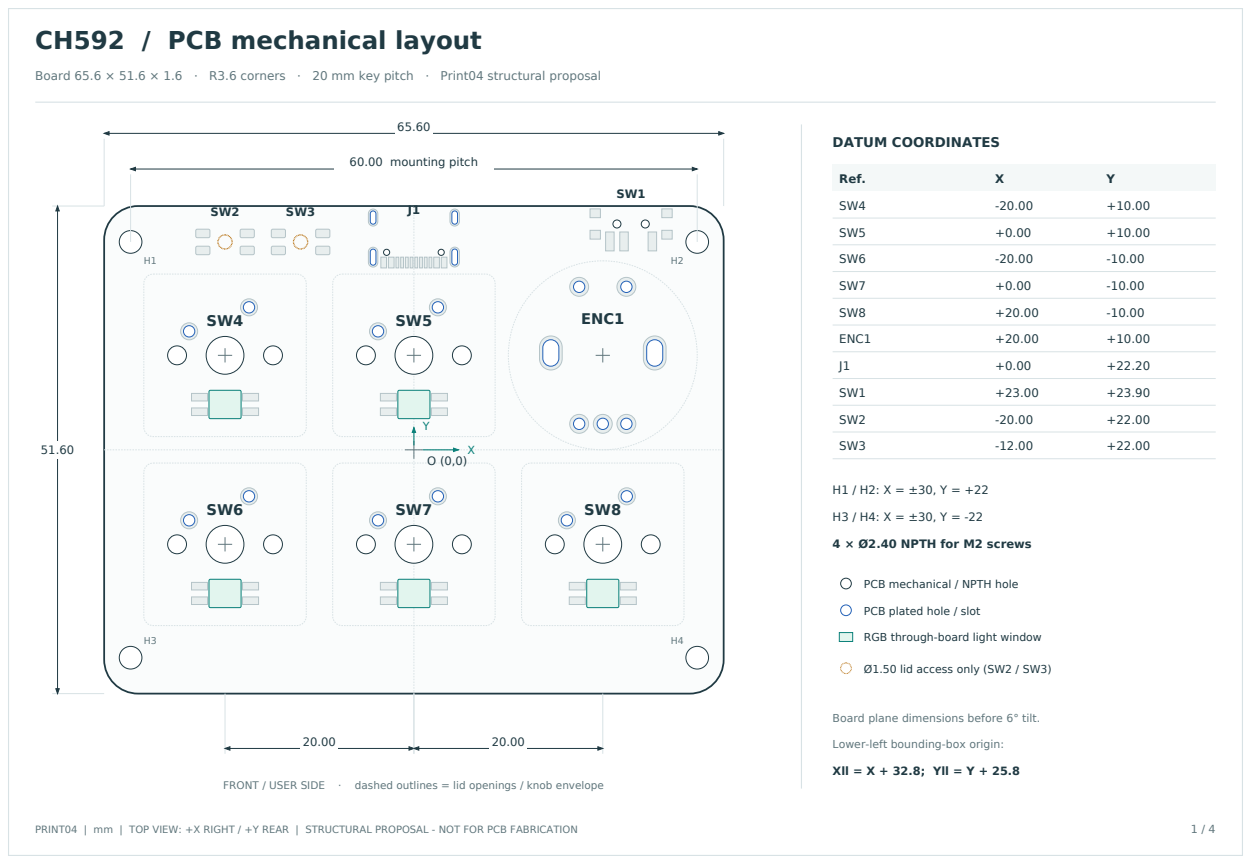
[picture p21: page 1]

Board 65.6 × 51.6 × 1.6 · R3.6 corners · 20 mm key pitch · Print04 structural proposal

PCB mechanical / NPTH hole

PCB plated hole / slot

RGB through-board light window

Board plane dimensions before 6° tilt.

Lower-left bounding-box origin:

# CH592 / Key switch and encoder drill details

## A SAMZO 28115181DM

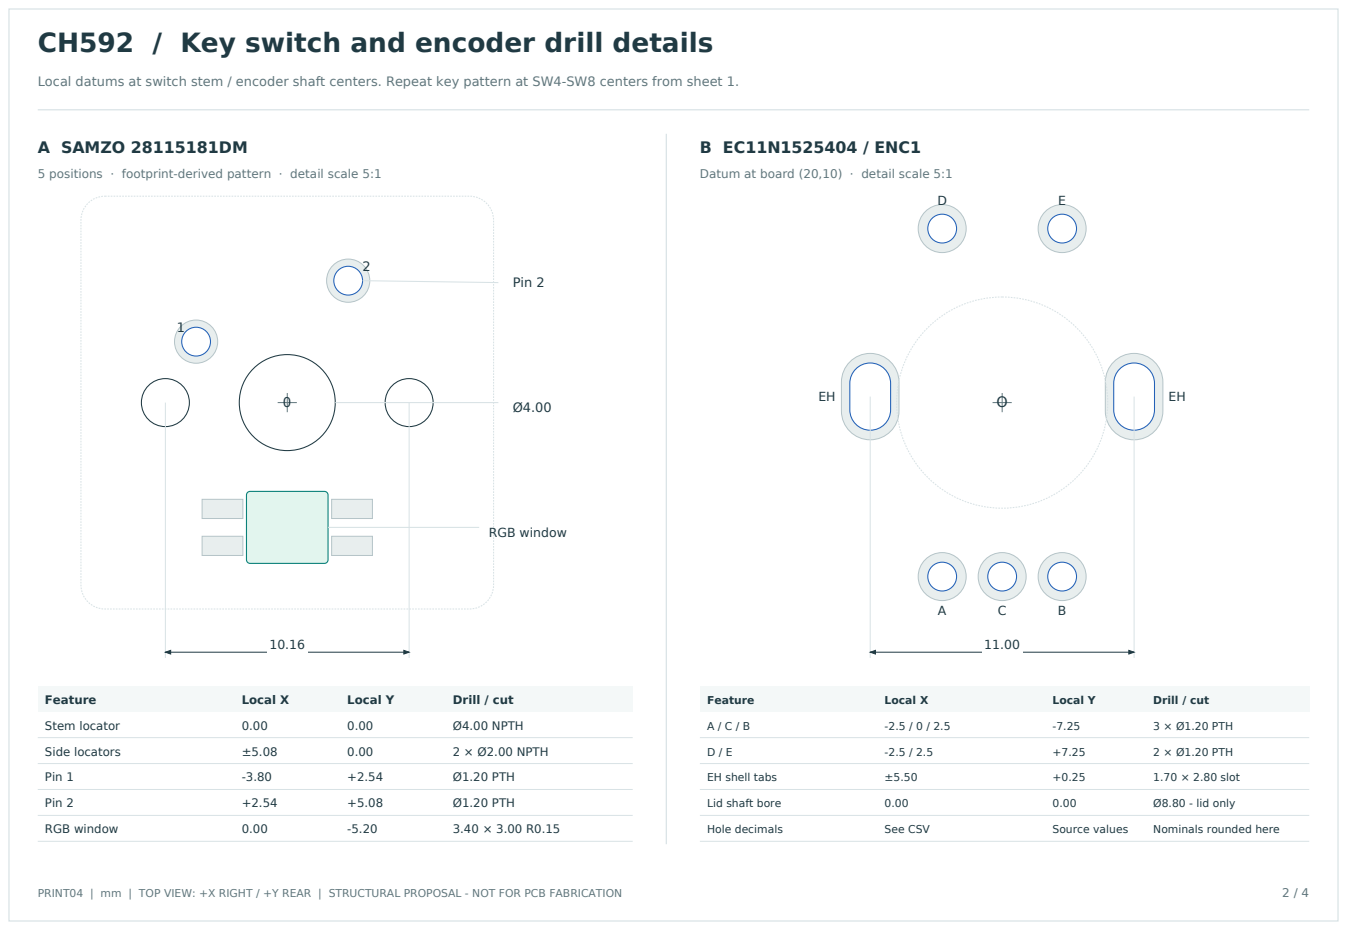
[picture p22: page 2]
PRINT04 | mm | TOP VIEW: +X RIGHT / +Y REAR | STRUCTURAL PROPOSAL - NOT FOR PCB FABRICATION; Pin 2; RGB window; Feature; Local X; Local Y; Drill / cut; Stem locator; Ø4.00 NPTH; Side locators; 2 × Ø2.00 NPTH; Pin 1; Ø1.20 PTH; B EC11N1525404 / ENC1; 3 × Ø1.20 PTH; 2 × Ø1.20 PTH; EH shell tabs; 1.70 × 2.80 slot; Lid shaft bore; Ø8.80 - lid only; Hole decimals; See CSV; Source values; Nominals rounded here

Local datums at switch stem / encoder shaft centers. Repeat key pattern at SW4-SW8 centers from sheet 1.

5 positions · footprint-derived pattern · detail scale 5:1

Datum at board (20,10) · detail scale 5:1

# CH592 / Rear interfaces and service access

## C GT-USB-7010ANS / J1

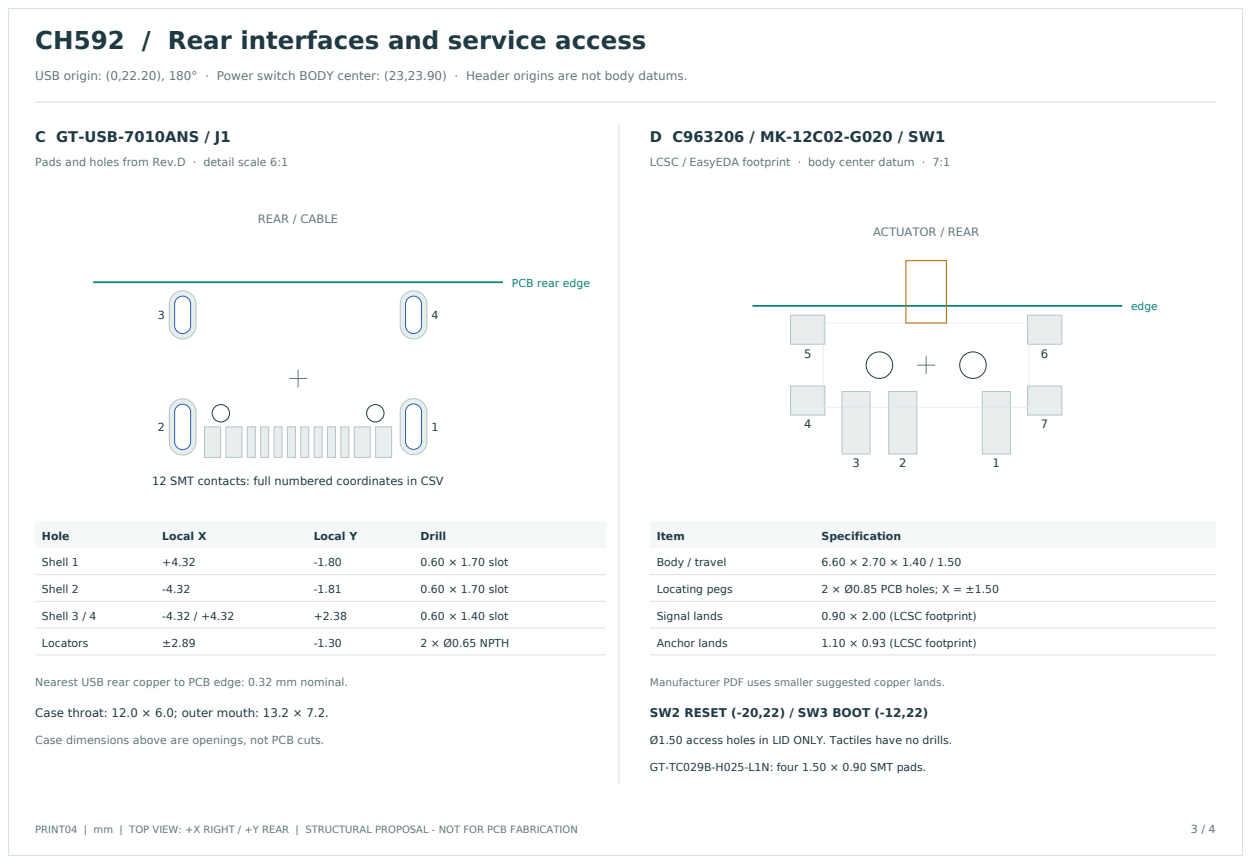
[picture p23: page 3]
PRINT04 | mm | TOP VIEW: +X RIGHT / +Y REAR | STRUCTURAL PROPOSAL - NOT FOR PCB FABRICATION; REAR / CABLE; Hole; Local X; Local Y; Drill; Shell 1; 0.60 × 1.70 slot; Shell 2; Shell 3 / 4; 0.60 × 1.40 slot; Locators; 2 × Ø0.65 NPTH; edge; ACTUATOR / REAR; Item; Specification; Body / travel; Locating pegs; 2 × Ø0.85 PCB holes; X = ±1.50; Signal lands; 0.90 × 2.00 (LCSC footprint); Anchor lands; 1.10 × 0.93 (LCSC footprint); SW2 RESET (-20,22) / SW3 BOOT (-12,22)

USB origin: (0,22.20), 180° · Power switch BODY center: (23,23.90) · Header origins are not body datums.

Pads and holes from Rev.D · detail scale 6:1

LCSC / EasyEDA footprint · body center datum · 7:1

PCB rear edge

12 SMT contacts: full numbered coordinates in CSV

Nearest USB rear copper to PCB edge: 0.32 mm nominal.

Manufacturer PDF uses smaller suggested copper lands.

Case throat: 12.0 × 6.0; outer mouth: 13.2 × 7.2.

Case dimensions above are openings, not PCB cuts.

Ø1.50 access holes in LID ONLY. Tactiles have no drills.

GT-TC029B-H025-L1N: four 1.50 × 0.90 SMT pads.

# CH592 / 1:1 alignment reference

## RELEASE NOTES

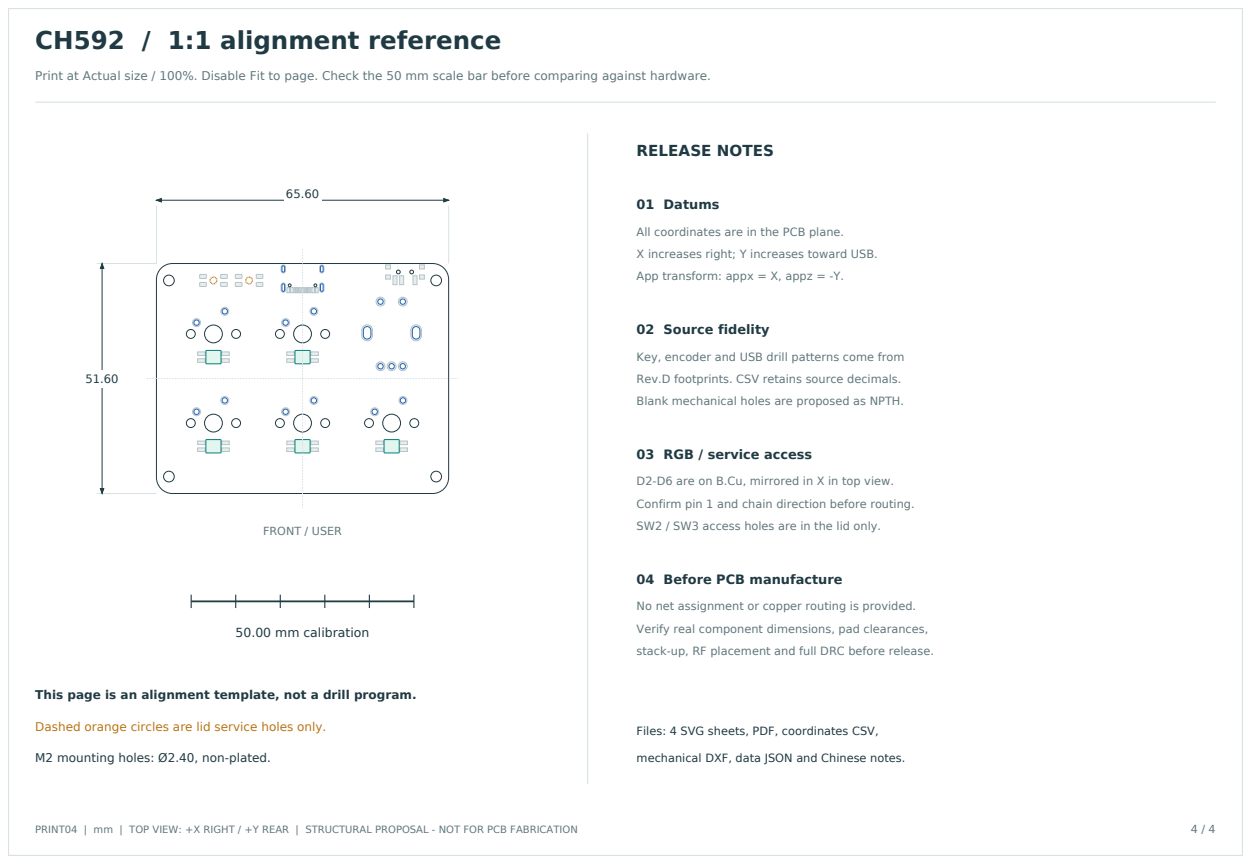
[picture p24: page 4]
PRINT04 | mm | TOP VIEW: +X RIGHT / +Y REAR | STRUCTURAL PROPOSAL - NOT FOR PCB FABRICATION; FRONT / USER; 50.00 mm calibration; 01 Datums; 02 Source fidelity

Print at Actual size / 100%. Disable Fit to page. Check the 50 mm scale bar before comparing against hardware.

All coordinates are in the PCB plane.

X increases right; Y increases toward USB.

App transform: appx = X, appz = -Y.

Key, encoder and USB drill patterns come from

Rev.D footprints. CSV retains source decimals.

Blank mechanical holes are proposed as NPTH.

03 RGB / service access

D2-D6 are on B.Cu, mirrored in X in top view.

Confirm pin 1 and chain direction before routing.

SW2 / SW3 access holes are in the lid only.

04 Before PCB manufacture

No net assignment or copper routing is provided.

Verify real component dimensions, pad clearances,

stack-up, RF placement and full DRC before release.

This page is an alignment template, not a drill program.

Dashed orange circles are lid service holes only.

Files: 4 SVG sheets, PDF, coordinates CSV,

M2 mounting holes: Ø2.40, non-plated.

mechanical DXF, data JSON and Chinese notes.
