jasonBrom/ch592f-keydeck/docs/VERIFICATION.md

# 本次整理验证记录

日期：2026-10-21。所有设备写入测试使用主机模拟与协议边界测试，本次没有刷写或改动实物。

| 检查 | 结果 |
| --- | --- |
| 网页 JS 测试 | 75 项通过，包括连接自动载入、宏、配置层、校准、显式在线桥接和无震动版保存 |
| Python 本地服务  | 8 项通过，包括 Host / Origin、令牌和命令白名单 |
| 固件主机验证脚本 | 通过：驱动、配置、存储、编码器中断、轮盘、USB/BLE、无震动版 |
| C / JS 交叉验证  | 主协议 34 项通过、无未解决发现；高级触觉、校准、配置层、实验接口和慢转轮盘检查通过 |
| WCH SDK 原始哈希 | 全部匹配 `vendor/SHA256SUMS.txt` |
| Make 带震动版 | 成功，BIN 181232 字节；与原交付 1.15 BIN 的 SHA-256 完全一致 |
| Make 无震动版 | 成功，BIN 175388 字节；HID 触觉报告已移除，能力位与命令拒绝验证通过 |
| HID 描述符 | 带震动版 508 字节，无震动版 403 字节；USB / BLE 报告长度与集合校验通过 |
| Pages 静态构建 | 通过；所有 HTML 本地链接、JS 相对导入与模型加载地址可解析，支持仓库子路径 |
| 浏览器手动检查 | 点选按键、音量映射草稿、宏示例、六个设置页、默认 3D 模型、双固件下载入口 |
| 手机宽度 | 页面无横向溢出，配置与底部操作可访问 |

CMake 备用配置已增加两版选项，但本机未安装 CMake，本次未执行该路径。实际构建使用固定版本 WCH GCC 8.2.0 / Make。

GitHub 仓库已推送到 `main`，云端 CI 与两种固件构建通过，Pages 已通过自定义 Actions 工作流发布。HTTPS 地址为 <https://jasonbrom.github.io/ch592f-keydeck/>。在线检查覆盖首页和 39 个网页/模型资源地址，4 个固件文件的 SHA-256 均匹配本地发布版本；页面能显示在线运行环境，初始控制台无脚本错误。记录见 [部署验证](DEPLOYMENT.md)。

新整理的无震动镜像仍需在对应硬件上验证 USB/BLE、灯光、输入和保存。带震动版二进制与旧镜像一致，但本次未重新上板验收。链接器预留栈已计入 RAM 区域，带震动版布局接近 26 KiB 上限；继续增加全局缓冲前应核对 map 和实测栈使用。

## 2026-10-22 连接与界面对齐

线上默认布局恢复为原本地版的深色和 3D 预览，两个运行方式共用 `web/public`。新增显式 Windows 已配对连接入口；在线请求仅访问回环地址，服务校验官方 Origin、跨域预检、来源独立令牌和会话，拒绝恶意 Origin、Host 和越界 API。新增测试通过；不修改固件与设备已保存配置。

## 2026-10-22 工作区交互调整

- 模型和编辑器约各占一半；模型按装配外形取景，窗口尺寸变化时重新适配。滚轮与加减按钮缩放相机，不发送旋钮输入；支持放大预览和 Esc 返回。
- 快捷功能改为触发动作下的折叠预设；连接说明集中在连接菜单，左侧保留模型、输入与配置层。
- 左侧色块直接修改现有配置层 RGB 数据，自动启用按层指示。三维指示灯使用编辑层颜色和独立亮度；实际键盘通过既有测试/保存事务生效，不自动写入设备。
- 连接菜单支持再次点击、关闭按钮、点击外部/模型和 Esc 收起。关闭状态明确隐藏面板，避免 CSS 定位令内容残留。
- 73 项网页测试通过，包括原相机缩放函数的距离边界、消息来源校验、层颜色与固件配置字节往返。浏览器实测缩放、模型内 Esc、快捷预设和菜单关闭；390 px 宽度无横向溢出。

## 2026-10-22 自动连接与充电状态

主「连接设备」按钮在用户点击后按 USB、Windows 已配对、浏览器已授权蓝牙的顺序识别；USB 成功时不请求本机网络权限，Windows 服务不可用时继续回退。手动通道入口保留，多设备或首次授权提示用户选择，已有管理会话仍拒绝抢占。打开页面不自动探测跨站回环服务。

底部「测试」临时应用草稿，保存才写入 Flash。相关帮助与状态提示同步改名。

充电状态按固件 STAT 位显示「充电中 / 未在充电」，断开后清空。不再以 USB、蓝牙、估算电量 100% 或 STAT 高推断已充满。硬件与固件没有独立的充满和 VBUS 检测，当前修复不需要重新刷写固件。新增自动识别、回退、USB 优先不触发权限、已占用会话和充电状态回归测试；网页共 73 项通过。

## 2026-10-22 色块对齐与连接后读取

配置层色块清除普通表单继承的上边距；「重新读取设备」直接放在底部操作栏，移除会叠在状态消息上的浮动入口。浏览器检查覆盖 1280 × 720、1414 × 1742、390 × 844 和 320 × 740，色块居中，底部按钮可见且无横向溢出。

每次自动或手动连接成功后，共用手动读取函数读取一次并刷新页面，以设备配置替换连接前的离线草稿，不发送配置写入。新增回归检查覆盖四种连接入口、连接过程重复点击、设备配置层与全部配置载入，以及读取失败保留草稿并允许手动重试；网页共 75 项通过。

Windows 已配对蓝牙实物检查：先修改离线草稿，再点击「连接设备」，页面自动载入设备当前配置层并显示「与设备一致」。检查完成后释放管理连接，未执行测试、保存或固件烧录。
