jasonBrom/ch592f-keydeck/(list of files, drawings)

Other design files:
web/public/pcb-mechanical-data.json
