jasonBrom/ch592f-keydeck/web/public/downloads/KeyDeck-ISP.ini

[Public]
MCUName=CH592
bMCULine=12
bMCUType=146
DataFlashFile=.
swzUserFile1=.
swzUserFile2=.
swzUserFile3=.
swzUserFile4=.
swzUserFile5=.
DataFlashFileSel=0
IsUserFile1Sel=0
IsUserFile2Sel=0
IsUserFile3Sel=0
IsUserFile4Sel=0
IsUserFile5Sel=0
[CH57x-58xUICfg]
bDnInterType=0
Baud=115200
DwnldCfgPin=PB22
BootPinNum=1
WProtectAddr=.
IsCodeProtect=1
IsRSTAsInputPin=1
ExtRSTPinSel=.
ExtRSTPinSelNum=0
IndependentWDGEn=0
IsSerialNoBtnDwnld=0
IsClearDataFlash=0
IsEraseAllCFlash=0
IsAfterDownRest=0
bVerifyType=0
Quick Verification Mode=1
