jasonBrom/ch592f-keydeck/firmware/features/hid_features.h

#ifndef C5_HID_FEATURES_H
#define C5_HID_FEATURES_H

#include <stdbool.h>
#include <stddef.h>
#include <stdint.h>

/* STATUS bits3/4: currently selected host owns rotation haptics/backlight. */
uint8_t c5_features_control_flags(void);

#define C5_HAPTIC_ID 0x05
#define C5_LAMP_ARRAY_ID 0x10
#define C5_LAMP_REQUEST_ID 0x11
#define C5_LAMP_RESPONSE_ID 0x12
#define C5_LAMP_MULTI_ID 0x13
#define C5_LAMP_RANGE_ID 0x14
#define C5_LAMP_CONTROL_ID 0x15
#define C5_HAPTIC_FEATURE_SIZE 9u
#define C5_HAPTIC_OUTPUT_SIZE 2u
#define C5_FEATURE_MAX_SIZE 50u
#define C5_FEATURE_USB 1u
#define C5_FEATURE_BLE 2u

void c5_features_init(void);
/* USB configured/awake; BLE encrypted/awake (independent of input CCCs).
 * Main context only. A disconnected source loses only its own host state. */
void c5_features_link_source(uint8_t source, bool ready);
void c5_features_link(bool usb_ready);
void c5_features_tick(uint32_t milliseconds);
/* HID payload only: transport owns the Report ID byte. GET is bounded RAM-only
 * and safe in USB IRQ; SET runs in the main loop (it can reach haptic I2C).
 * type 2 = Output, type 3 = Feature. false requests USB STALL.
 */
size_t c5_features_get(uint8_t report_id, uint8_t *out, size_t capacity);
bool c5_features_set(uint8_t report_type, uint8_t report_id,
                     const uint8_t *data, size_t length);
size_t c5_features_get_source(uint8_t source, uint8_t report_id,
                              uint8_t *out, size_t capacity);
bool c5_features_set_source(uint8_t source, uint8_t report_type,
                            uint8_t report_id, const uint8_t *data, size_t length);
/* GET snapshots one complete payload. For BLE long reads cache it at offset 0
 * and slice that cache for Read Blob: lamp-attribute GET advances its cursor.
 * SET validates the entire report before changing state; false must become an
 * ATT error/USB STALL. Legacy get/set/link functions target USB only.
 * Arbitration follows configuration transport preference, with USB priority in
 * auto mode. Inactive hosts may retain lamp/auto-haptic state, but manual haptic
 * output from an inactive source is rejected and cannot stop the active host. */
/* Call with final locally rendered colors immediately before the lights HAL.
 * Autonomous mode records them; host mode replaces them only while awake.
 * false forces black even if Windows retains LampArray ownership. Status LED
 * is separate; cached host colors remain available for a later idle wake.
 */
bool c5_features_lights(uint8_t rgb[15], bool awake);
void c5_features_auto_haptic(uint8_t local_strength);

/* Insert after the Radial physical collection closes, before its Application
 * collection closes. Feature ID5: auto(1), control(4), intensity(1),
 * waveform ordinal(1), duration milliseconds(2). Output ID5: ordinal,intensity.
 * USB HUT 1.4 section 17: triggers use ORDINALS, not waveform usage IDs.
 */
#define C5_HAPTIC_REPORT_MAP_BYTES \
  0xa4,0x55,0x00,0x65,0x00,0x35,0x00,0x45,0x00, \
  0x05,0x0e,0x09,0x01,0xa1,0x02,0x85,0x05, \
  0x09,0x20,0x15,0x00,0x25,0x03,0x75,0x08,0x95,0x01,0xb1,0x02, \
  0x09,0x21,0x91,0x02, \
  0x09,0x22,0x17,0x37,0x00,0x01,0x00,0x27,0x37,0x00,0x01,0x00, \
  0x75,0x20,0xb1,0x03, \
  0x09,0x23,0x15,0x00,0x25,0x64,0x75,0x08,0xb1,0x02, \
  0x09,0x23,0x91,0x02, \
  0x09,0x10,0xa1,0x02,0x05,0x0a,0x09,0x03, \
  0x15,0x03,0x25,0x03,0x36,0x03,0x10,0x46,0x03,0x10,0xb1,0x03,0xc0, \
  0x05,0x0e,0x09,0x11,0xa1,0x02,0x05,0x0a,0x09,0x03, \
  0x15,0x00,0x27,0xff,0xff,0x00,0x00,0x35,0x00,0x45,0x00, \
  0x66,0x01,0x10,0x55,0x0d,0x75,0x10,0xb1,0x03,0xc0,0xc0,0xb4

#define C5_LAMP_RGBA_USAGES \
  0x09,0x51,0x09,0x52,0x09,0x53,0x09,0x54
/* Native LampArray implementation: six Feature reports, 5 physical key LEDs.
 * Layout follows Microsoft reference; IDs remapped to 0x10..0x15.
 */
#define C5_LAMP_REPORT_MAP_BYTES \
  0xa4,0x55,0x00,0x65,0x00,0x35,0x00,0x45,0x00, \
  0x05,0x59,0x09,0x01,0xa1,0x01, \
  0x85,0x10,0x09,0x02,0xa1,0x02, \
  0x09,0x03,0x15,0x00,0x27,0xff,0xff,0x00,0x00,0x75,0x10,0x95,0x01,0xb1,0x03, \
  0x09,0x04,0x09,0x05,0x09,0x06,0x09,0x07,0x09,0x08, \
  0x27,0xff,0xff,0xff,0x7f,0x75,0x20,0x95,0x05,0xb1,0x03,0xc0, \
  0x85,0x11,0x09,0x20,0xa1,0x02,0x09,0x21, \
  0x27,0xff,0xff,0x00,0x00,0x75,0x10,0x95,0x01,0xb1,0x02,0xc0, \
  0x85,0x12,0x09,0x22,0xa1,0x02,0x09,0x21,0xb1,0x02, \
  0x09,0x23,0x09,0x24,0x09,0x25,0x09,0x27,0x09,0x26, \
  0x27,0xff,0xff,0xff,0x7f,0x75,0x20,0x95,0x05,0xb1,0x02, \
  0x09,0x28,0x09,0x29,0x09,0x2a,0x09,0x2b,0x09,0x2c,0x09,0x2d, \
  0x26,0xff,0x00,0x75,0x08,0x95,0x06,0xb1,0x02,0xc0, \
  0x85,0x13,0x09,0x50,0xa1,0x02,0x09,0x03,0x25,0x08,0x95,0x01,0xb1,0x02, \
  0x09,0x55,0x25,0x01,0xb1,0x02,0x09,0x21, \
  0x27,0xff,0xff,0x00,0x00,0x75,0x10,0x95,0x08,0xb1,0x02, \
  C5_LAMP_RGBA_USAGES,C5_LAMP_RGBA_USAGES,C5_LAMP_RGBA_USAGES,C5_LAMP_RGBA_USAGES, \
  C5_LAMP_RGBA_USAGES,C5_LAMP_RGBA_USAGES,C5_LAMP_RGBA_USAGES,C5_LAMP_RGBA_USAGES, \
  0x26,0xff,0x00,0x75,0x08,0x95,0x20,0xb1,0x02,0xc0, \
  0x85,0x14,0x09,0x60,0xa1,0x02,0x09,0x55,0x25,0x01,0x95,0x01,0xb1,0x02, \
  0x09,0x61,0x09,0x62,0x27,0xff,0xff,0x00,0x00,0x75,0x10,0x95,0x02,0xb1,0x02, \
  C5_LAMP_RGBA_USAGES,0x26,0xff,0x00,0x75,0x08,0x95,0x04,0xb1,0x02,0xc0, \
  0x85,0x15,0x09,0x70,0xa1,0x02,0x09,0x71,0x25,0x01,0x95,0x01,0xb1,0x02, \
  0xc0,0xc0,0xb4
#endif
