jasonBrom/ch592f-keydeck/firmware/platform/ch592/hid_reports.h

#ifndef C5_HID_REPORTS_H
#define C5_HID_REPORTS_H
#include "hid_compact_map.h"
/* One shared report map for USB HID and Bluetooth HOGP. Every collection resets
 * inherited global units/ranges: the Dial's angular unit must not leak to Mouse.
 * IDs: keyboard=1 (8 bytes), consumer=2 (2), radial=3 (3), mouse=4 (4).
 */
#define C5_HID_REPORT_MAP_BYTES C5_HID_REPORT_MAP_WITH_HAPTIC()
#define C5_HAPTIC_INSERT_BYTES C5_HAPTIC_REPORT_MAP_BYTES,
#ifdef C5_NO_HAPTICS
#include "hid_no_haptic_map.h"
#define C5_FULL_HID_REPORT_MAP_BYTES C5_NO_HAPTIC_HID_REPORT_MAP_BYTES
#else
#define C5_FULL_HID_REPORT_MAP_BYTES C5_COMPACT_HID_REPORT_MAP_BYTES
#endif
#define C5_HID_REPORT_MAP_WITH_HAPTIC(EXTRA) \
  0x05,0x01,0x09,0x06,0xa1,0x01,0x85,0x01, \
  0x05,0x07,0x19,0xe0,0x29,0xe7,0x15,0x00,0x25,0x01, \
  0x75,0x01,0x95,0x08,0x81,0x02,0x75,0x08,0x95,0x01,0x81,0x03, \
  0x05,0x08,0x19,0x01,0x29,0x05,0x75,0x01,0x95,0x05,0x91,0x02, \
  0x75,0x03,0x95,0x01,0x91,0x03, \
  0x05,0x07,0x19,0x00,0x29,0xe7,0x15,0x00,0x26,0xe7,0x00, \
  0x75,0x08,0x95,0x06,0x81,0x00,0xc0, \
  0x05,0x0c,0x09,0x01,0xa1,0x01,0x85,0x02, \
  0x15,0x00,0x27,0xff,0xff,0x00,0x00,0x19,0x00,0x2a,0xff,0xff, \
  0x75,0x10,0x95,0x01,0x81,0x00,0xc0, \
  0x05,0x01,0x09,0x0e,0xa1,0x01,0x85,0x03, \
  0x05,0x0d,0x09,0x21,0xa1,0x00, \
  0x05,0x09,0x09,0x01,0x15,0x00,0x25,0x01, \
  0x75,0x01,0x95,0x01,0x81,0x02,0x75,0x07,0x81,0x03, \
  0x05,0x01,0x09,0x37,0x16,0xf0,0xf1,0x26,0x10,0x0e, \
  0x36,0xf0,0xf1,0x46,0x10,0x0e,0x55,0x0f,0x65,0x14, \
  0x75,0x10,0x95,0x01,0x81,0x06,0xc0,EXTRA 0xc0, \
  0x05,0x01,0x09,0x02,0xa1,0x01,0x85,0x04, \
  0x55,0x00,0x65,0x00,0x35,0x00,0x45,0x00, \
  0x09,0x01,0xa1,0x00,0x05,0x09,0x19,0x01,0x29,0x05, \
  0x15,0x00,0x25,0x01,0x75,0x01,0x95,0x05,0x81,0x02, \
  0x75,0x03,0x95,0x01,0x81,0x03, \
  0x05,0x01,0x09,0x30,0x09,0x31,0x09,0x38, \
  0x15,0x81,0x25,0x7f,0x75,0x08,0x95,0x03,0x81,0x06,0xc0,0xc0

/* Vendor interface is separate from protected keyboard/mouse collections.
 * Payload is 63 bytes plus ID; USB transfer is one 64-byte packet.
 */
#define C5_CONFIG_REPORT_MAP_BYTES \
  0x06,0x60,0xff,0x09,0x61,0xa1,0x01,0x85,0x20, \
  0x15,0x00,0x26,0xff,0x00,0x75,0x08,0x95,0x3f, \
  0x09,0x62,0x81,0x02,0x09,0x63,0x91,0x02,0xc0
#endif
