jasonBrom/ch592f-keydeck/(commit log)

2026-10-21 Initial KeyDeck web console and dual firmware variants
    [component-centers.csv, key-locator-14.0.stl, key-locator-14.1.stl, key-locator-14.2.stl, lower-fit-corner.stl, lower-port-fit.stl, lower-resin.stl, lower-shell.stl]
2026-10-21 Restore local console layout and connect hosted Windows paired devices
2026-10-21 Auto-detect connection channels and correct charging status
2026-10-22 Align layer color controls and keep device reload visible
2026-10-22 Load device configuration once after every connection
